airpocket-soundman/IchiPing-UNO-Q/uno_q/audio/reports/2026-09-11-speaker-pass.md

# Bounded speaker playback PASS — 2026-09-11

- Time: 22:54 JST (final listening confirmation).
- Board: Arduino UNO Q, ADB serial `2261748543`, Debian kernel
  `6.16.7-g0dd6551ae96b`.
- Audio hardware connected: MAX98357A, speaker, INMP441, common ground;
  MAX98357A SD connected to SOC_GPIO_28 with an external 10 kOhm pulldown.
- Software: current working-tree `safe-audio-test.sh`,
  `audio-smoke-test.py`, SD_MODE Device Tree route, and Arduino Bridge LED
  Matrix marker. This result precedes a repository commit.
- Stimulus: generated 440 Hz stereo S16_LE PCM at 48 kHz, 0.5 seconds.
- Result at 0.3%FS: user heard a clean sine wave; playback stopped after the
  bounded interval.
- Result at 0.6%FS: user reported the test was fully satisfactory. PCM transfer
  completed, then the route was disabled, SD_MODE returned Low, and markers
  were cleared. No board reset was requested.
- Verdict: **PASS for generated speaker playback and bounded stop control.**
  Microphone capture quality and capture-to-speaker replay remain unvalidated.
