airpocket-soundman/IchiPing-UNO-Q/uno_q/audio/reports/2026-09-10-owon-api.md

# OWON API bring-up — 2026-09-10 19:20–19:22 JST

結果: USB/API取得・停止は成功。**電圧換算はレンジ依存の不整合があり未検証。**
UNO Qの再生、録音、リセットは行っていない。マイク・アンプは取り外したまま。

- 実機: VDS1022I25070056、hardware V5.0.1、FPGA v5。
- API: florentbr/OWON-VDS1022、commit a21cee14fc0807ce804657a26772784c4e47b5ef、package 1.1.5。
- 専用venv: `C:/Users/yamas/AppData/Local/Programs/OWON-VDS1022-API/venv`。
- 公式GUIを閉じ、既存のlibusb-win32ドライバーを使用。ドライバー置換なし。
- Windows libusb0のLinux専用is_kernel_driver_active問い合わせがNotImplementedErrorに
  なるため、ラッパー内でWindows/libusb0の場合のみ非該当として扱う。
- ラッパーはFPGAロード、flash書込み、校正保存を禁止。
  既存FPGAイメージが未ロードなら停止する。校正値は読取りのみ。
- calibration SHA256: f5987fd7ee31303933797a418b03cc03f9bfd389daca60914cfc636550e4e3e3。

## 補償出力測定

CH1のみ補償用5V/1kHzへ接続確認済み。CH2の補償接続は未確認で評価しない。
両CH ×10/DC、1.25MS/s、5000点/CH、CH1 rising 2.5V単発。

| run | API全画面レンジ | 波形エッジからの周波数 | p90−p10振幅 | stop応答 |
|---|---:|---:|---:|---|
| 03 | 20 V | 1000 Hz | 10.08 Vpp | true |
| 04 | 50 V | 1000 Hz | 4.80 Vpp | true |
| 05 | 20 V | 1000 Hz | 10.08 Vpp | true |

`local-runs/owon-api-compensation-03`～`05` にADC生値npz、電圧CSV、
機器識別・設定・統計JSON・実行ログを保存（git対象外）。01/02は接続API互換性エラー。
API内蔵周波数カウンター値は0/832Hz等も返したため、短い取得では信用せず
CSV内の立ち上がり周期から計算した値を採用した。

GUIは50V全画面レンジで約5Vppだった。APIの50Vレンジは概ね整合するが、
20Vレンジの2倍表示が再現する。原因は未確定で、V5固有の設定・校正テーブル・
ゲイン制御を調査する。単純に全データを1/2倍して隠さない。
絶対電圧のオフセットも未校正。これらが解決するまで1.8V I²Sの電気的合否には使わない。

## 実行方法

`owon-capture.py` は既定では何も接続しない。補償信号接続済み、GUI終了後にのみ:

```powershell
& C:/Users/yamas/AppData/Local/Programs/OWON-VDS1022-API/venv/Scripts/python.exe uno_q/audio/owon-capture.py uno_q/audio/local-runs/NEW-RUN --range-v 50 --execute
```

出力ディレクトリの上書き禁止、親プロセスの20秒タイムアウトあり。
タイムアウト時は子を終了するが、停止応答は未確認として記録する。
本ラッパーは補償信号向け。UNO Qの0.5秒試験との同期取得はまだ未実装。
