airpocket-soundman/IchiPing-UNO-Q/uno_q/audio/reports/2026-09-10-owon-i2s.md

# 無負荷I²S API測定 — 2026-09-10 20:10–20:12 JST

最新結果: **GPIO98の約3.072 MHzとGPIO99の約48 kHz WSを取得。64クロック/WS周期を確認。**
以前のWS未検出は短いBCLK開始直後の観測に限られる。電圧精度・データ出力・音響品質は未判定。

## 対象・条件

- UNO Q USB serial 2261748543、VID/PID 2341:0078（各試験スクリプトで確認）。
- kernel 6.16.7-g0dd6551ae96b、q6asm-dai SHA256
  c4292c7c9504c7aa01a94cd0007b86213def67a1d4a8123dd23be3ff92653526。
- OWON VDS1022I25070056、hardware V5.0.1、FPGA5、非公式API1.1.5。
- CH1=GPIO98、CH2=GPIO99、共通GND、両プローブ×10/DC。
  ユーザーの「OK」を直前の配線確認への回答として扱った。
- アンプ・マイクは取り外し済み。スピーカー音響テストではない。
- 全画面20Vレンジ、CH1立上がり1.6V指定（API尺度）。
  補償測定でレンジ依存の電圧不整合があるため絶対電圧は合否判定に使わない。
- 48 kHz / stereo / S32_LEの全ゼロPCM、既存instrument-playbackを使用。
  ルート有効化前から500msの独立systemd強制再起動タイマー。期限延長なし。

## 取得

APIの設定キューをwait()で送信後、armed.jsonを保存。
両試験ともalready_triggered=0を確認してからsudo認証を通し、UNO Q試験を開始。
オシロの待機上限60秒は取得待ちの上限であり、UNO Qの500ms期限とは独立。
ADC、CSV、設定・解析JSONをlocal-runs/owon-api-i2s-01と02に保存（git対象外）。

| run | UNO試験開始 JST | サンプルレート | 全幅 | CH1平均周波数 | CH2 | scope stop応答 |
|---|---|---:|---:|---:|---|---|
| 01 | 20:10:56 | 100 MS/s | 50 µs | 3.071400 MHz | WS未確認 | true |
| 02 | 20:12:27 | 25 MS/s | 200 µs | 3.072458 MHz | WS未確認 | true |

CH1は記録中央付近から立ち上がり、後半がクロック列。
したがって実際に観測した駆動区間は約25µs/100µsと短く、定常動作全体ではない。
CH2のp90−p10はAPI尺度で0.16V、48kHzの矩形波は識別できなかった。
この時点ではプローブ・CH2・接触・測定位置・WS開始遅延を除外できない。

run01の元JSONは単一周期サンプル数の中央値から3.030303MHzを出している。
これは周期が32/33点に量子化されるため。全77周期/2507点から3.071400MHzと算出。
以後のコードは全立上がり区間平均に修正。元データは書き換えない。

## 復旧・停止確認

開始前はALSAカードが消失していた。USB識別とaplay/arecord不在確認後、
idle ADSP remoteproc1をstop/startしてカードを回復した。
run01後はboot ID b423aafa-bcf8-4733-8e41-e10dd0e1ba5eに変わり、
前bootのwatchdogログに11:10:57 UTCのRebootingを確認。
これは再起動実施の確認で、厳密な500ms以内のピン停止を実測したものではない。
run02後はSSH再接続が一時タイムアウトしたが、その後復帰。
boot ID 44647f13-f9a2-4459-82b3-b79c9abd2f9cと、前bootの
11:12:28 UTCのwatchdog Rebootingログを確認した。

## 次の切り分け

無負荷を維持し、CH1/CH2ともGPIO98へ接続して測定系を比較する。
同じクロックが両CHに出れば、99番へ戻しWSの開始遅延も含めて測る。
測定系を確認するまでWS出力故障やソフト原因とは断定しない。

## 両CHをGPIO98へ接続した比較 — 20:20:55 JST

ユーザーが両方98番への接続を明示確認。アンプ・マイク未接続、GND・×10を維持。
ボード・kernel・q6asm・OWON/API・校正hashは上記と同一。
100MS/s、5000点、50µs、20V全幅、CH1立上がり1.6V（API尺度）。
同じ500msリセット期限付きゼロPCMを1回実行。

- `local-runs/owon-api-both98-01`: 試験前のalready_triggered=3のためUNO実行を中止。
  取得は60秒タイムアウト、当該runのscope停止応答は未確認。波形評価には使わない。
- `owon-capture.py`に初期化設定送信→明示STOP→測定設定→RUNを追加。
  stop()は初期化キューを破棄するため、キューを送信するsend(SET_RUNSTOP,1)を使用。
- `local-runs/owon-api-both98-02`: already_triggered=0を確認後にUNO試験を開始。
  CH1/CH2とも平均3.071400MHz、p90−p10=2.00V（API尺度、絶対値未検証）。
  生ADC相関0.998035、完全一致サンプル0.26%。別チャネルの実測値としてほぼ同じ波形。
  API取得後stop_acknowledged=true。SVGを保存し公式アプリを再起動。
- 比較の合否: 両CHでBCLK検出は成功。電圧精度・音質の合格ではない。
  CH2の恒常的な無応答は否定できるが、前回99番の接触不良や開始遅延は未除外。
- UNO再起動直後のSSHは一時タイムアウトしたが復帰。
  boot ID 11b2a1f9-5068-43cb-b76c-d6f4cb9a4d56、前bootの11:20:56 UTC
  watchdog Rebootingログを確認。厳密なピン停止時間を実測したものではない。

次はCH1を98番に維持し、CH2を99番へ戻して接触確認後、WSを再測定する。

## CH2を99へ戻して再測定 — 20:26–20:27 JST

ユーザーがCH2=99を明示確認。CH1=98、アンプ・マイク未接続、×10/DC/GND共通。
機器識別・kernel・q6asm・校正hashは上記と同一。全ゼロPCM、500ms期限を維持。
再度ALSAが消えていたため、USB識別と再生・録音不在確認後にidle ADSP stop/startで回復。
公式アプリは終了し、以後再起動せずSVGを提示する。

| local-runs末尾 | UNO開始JST | 設定 | 結果 |
|---|---|---|---|
| owon-api-ws-return-01 | 実行せず | 25MS/s | 試験前trigger=3、破棄。取得timeout、当該停止応答未確認 |
| owon-api-ws-return-02 | 20:26:07 | 25MS/s、200µs | CH1 3.072458MHz、CH2 WS未確認、p90−p10=0.16V* |
| owon-api-ws-return-03 | 20:27:42 | 1MS/s、5ms | CH2 WS未確認、p90−p10=0.08V*。CH1は帯域不足で評価禁止 |

*V値は未検証API尺度であり、物理的な電圧精度を保証しない。
02/03は試験前trigger=0を確認後に実行し、取得後scope stop=true。
誤トリガー時は即例外で終了・停止する処理を追加（01実行後から適用）。
03の5ms記録は前後半を含むため、クロック開始後を見た時間は約2.5ms。
これより後のWS開始を除外したわけではない。BCLKのaliasはJSON/SVGに明記。
02の再起動boot ID c1e54395-3b6b-495c-a795-3d4a3e2e3d1d、前bootの11:26:08 UTC
watchdog開始ログを確認。03もboot ID b6d5afec-164d-44d9-b9ec-1d1a7e71488fへ変化、
前bootの11:27:43 UTC watchdog開始ログを確認。厳密なピン停止時間の実測ではない。

判断: CH2の恒常的な無応答では説明できず、99番のピン設定・実測接触位置・
WS開始遅延を次に確認する。アンプは未接続なので、今回のWS未検出をアンプ負荷のせいにはできない。
ただし全駆動期間のWS不在、ソフト障害、ノイズ原因の確定には至っていない。

## WS自身のトリガーによる取得成功 — 20:40:47 JST

同じUNO Q 2261748543 / 2341:0078、kernel 6.16.7-g0dd6551ae96b、q6asm hashは上記と同一。
OWON VDS1022I25070056 / V5.0.1 / FPGA5 / API1.1.5、校正hash不変。
アンプ・マイク未接続、CH1=98、CH2=99、×10/DC/GND共通。
全ゼロPCM、500ms独立リセット期限を維持し、1回試験。

実機pinmux-pinsでgpio6=i2s1_clk、gpio7=i2s1_ws、gpio8/9=i2s1_data、owner=soundを確認。
[Arduino公式カーネル定義](https://github.com/arduino/linux-qcom/blob/qcom-v6.16.7-unoq/drivers/pinctrl/qcom/pinctrl-sm6115-lpass-lpi.c)
とも整合。根拠なくDTやカーネル設定を変更していない。

取得をCH2 rising 1.6V（API尺度）、25MS/s・5000点・200µsへ変更。
`local-runs/owon-ws-trigger-01`に保存。armed時trigger=0、取得後stop=true。
CH1平均3.071758MHz、CH2平均47.984645kHz、連続4つのWS周期内BCLKエッジ数は全て64。
WSが始まる前の約100µsにもBCLKが存在し、WS開始時点を捕捉した。
過去のBCLK-trigger記録では開始後2.5msまでWSなし、今回WS-triggerではWSを取得。
同一試験で開始間隔全体は測っていないため、遅延時間を厳密には確定しない。
これまでの未検出をWS出力故障とは解釈しない。周波数・比率確認は成功、音響品質合格ではない。

APIにtrigger-ch選択、45秒の停止タイマー（親60秒上限）を追加。これはオシロ待機であり、
UNO Qの500ms期限を延ばさない。データ測定に備えてCH2=101の記録指定も追加。
次の物理操作はCH2のみ99→101。未変更のためデータ線の実測はまだ行っていない。
試験後boot ID bc0a8655-d0d5-4a1e-b849-3b66489f500fと11:40:48 UTCのwatchdog
Rebootingログを確認。再起動は確認済みだが、厳密なピン停止時間の実測ではない。
