airpocket-soundman/IchiPing-UNO-Q/docs/HANDOFF_2026-09-12.md

# IchiPing UNO Q 引継ぎ資料 — 2026-09-12 JST

## 1. 最初に読むこと

このリポジトリは元IchiPingをArduino UNO Qへ移植する独立プロジェクトである。
元の `airpocket-soundman/IchiPing` は参照専用で、変更・逆同期しない。

- 開発方針・配線・GPIOの正本: [`docs/uno_q_port.html`](uno_q_port.html)
- UNO Qアプリの正本: [`uno_q/app/`](../uno_q/app/)
- 今回の実装監査: [`uno_q/reports/2026-09-12-implementation-gap-audit.md`](../uno_q/reports/2026-09-12-implementation-gap-audit.md)
- 音響bring-up: [`uno_q/audio/README.md`](../uno_q/audio/README.md)
- GPIO28 / MAX98357A SD制御: [`uno_q/audio/SDMODE_GPIO28.md`](../uno_q/audio/SDMODE_GPIO28.md)
- オリジナルUI比較: [`uno_q/reports/2026-09-12-original-ui-port.md`](../uno_q/reports/2026-09-12-original-ui-port.md)

## 2. 現在の結論

ILI9341、D3–D8入力、PCA9685、5台のSG90、Router Bridge、MI2S0再生・録音、
ONNXモデル単体のbring-upは完了している。2026-09-12に、EXECから録音、前処理、
baseline差分、ONNX推論、TFT表示までのソフト経路も統合した。

ただし、ホワイトノイズの実機音量が学習データ相当に校正されていないため、root所有の
音響workerは意図的に未インストールである。現在のEXECは発音・録音しない。この状態を
回避して推論成功を装うloopback/dummy経路はない。

サーボ制御も再起動後は必ず未armed・自動追従OFFである。5台すべての同期が成功するまで
TFTの `act` は `-----` を表示する。同期後の `act` も位置センサー値ではなく、最後に成功
した端点指令を表す。

雨検知は対象外である。D9は予約・未使用のままにする。

## 3. 実機と稼働状態

| 項目 | 現在値 |
|---|---|
| ボード | Arduino UNO Q、USB serial `2261748543` |
| Wi-Fi | host `unoQ4G`、直近IP `192.168.50.160` |
| Linuxログイン | 試験ユーザー `airpocket`。パスワードはGitへ記録しない |
| アプリ配置 | `/home/arduino/ArduinoApps/ichiping-uno-q` |
| アプリ名 | `IchiPing UNO Q` |
| アプリ状態 | running、直近確認時container restart count 0 |
| MCUビルド | program 31,432 bytes、global RAM 6,596 bytes |
| 起動status | `0x03`: ILI9341初期化送信済み、PCA9685検出 |
| 起動入力 | switch request `0b11111`、servo state `unknown` |
| 音響worker | 未有効。`worker-ready.json`なしが正常 |
| baseline | 未収録 |

直近配備ソースのSHA-256は以下。再配備前の照合に使用できる。

| ファイル | SHA-256 |
|---|---|
| `sketch/sketch.ino` | `305cea7ddce6133afddecfec10fd5829e592271c26a3bb611b68b060823b8668` |
| `sketch/ili9341_display.cpp` | `1d42182fc9c7b3cbacf2388a7b9cd00c703ebd2af733ffad2502914f36d098a0` |
| `sketch/ili9341_display.h` | `a3d2635a924e820fb8f10cc062e0d667a5f293e44a2780440592004d7f761430` |
| `python/main.py` | `5eed43f6227800a120ae275fa10b8521014586d07cc4f4e2f8b568e9d80e612d` |

## 4. 現行配線

### ILI9341

`D11=MOSI`、`D13=SCK`、`A2=CS`、`A3=RST`、`A4=DC`、`A5=BL`、
`3V3`、`GND`。書込専用なのでD12/MISOは未接続。

### スイッチ・EXEC・サーボ

- D3–D7: bit 0..4 = 窓a、窓b、窓c、扉AB、扉BC
- 状態スイッチ: GND接続Low=CLOSE(0)、解放High=OPEN(1)
- D8: EXEC、Low=押下
- D20/SDA、D21/SCL: PCA9685アドレス0x40
- PCA9685 ch 0..4: a、b、c、AB、BC
- サーボ: 0°/tick 102=OPEN、180°/tick 553=CLOSE
- サーボ電源: 外部5 V、UNO QとGND共通。3.3 V端子から給電しない

### MI2S0

| 信号 | SoC GPIO | 接続 |
|---|---:|---|
| BCLK/SCK | 98 | MAX98357A BCLK、INMP441 SCK |
| WS/LRC | 99 | MAX98357A LRC、INMP441 WS |
| mic SD / DATA0 | 100 | INMP441 SD |
| amp DIN / DATA1 | 101 | MAX98357A DIN |
| amp SD_MODE | 28 | MAX98357A SD、SD–GND外付け10 kΩ必須 |

48 kHz、stereo、S32_LEコンテナ内上位24 bit。INMP441 L/R=GND、VDD=1.8 V。
MAX98357A GAIN=GND、VIN=5 V。信号は標準UNO D番号ではなくJMISC／UNO Breakout
Carrier経由である。配線変更は必ず電源OFFで行う。

## 5. 完了している実装

- 元IchiPing project 10準拠のILI9341横画面、`inf`/`act`、物理順
  `c, BC, b, AB, a`、可観測性の色、3段階判定
- EXEC要求のmailbox化。Bridge provider内の同期再入によるtimeoutを解消
- 6秒録音、中央2秒抽出、48 kHz→16 kHz変換、Welch特徴量、baseline差分
- モデルSHA、入出力名・shape、サンプルレート、状態順のmanifest検証
- 3本の全閉baselineをatomic保存し、モデル変更・破損時に拒否する処理
- 録音時間、無音、クリップ、左右slot漏れの健全性検査
- 収録時状態とrequest IDによる古い推論結果の拒否
- 推論busy中のEXEC抑止とサーボ同期延期
- PCA9685全16ch FULL_OFF、明示arming、ch 0..4制限、障害ラッチ
- MAX98357A SD_MODEのGPIO28制御、正常終了・例外時のroute offとSD Low
- root音響workerとApp Labコンテナのファイルspoolによる権限分離
- オンボードLED Matrix依存の削除。音響マーカーはLinux緑LEDのみ

暫定Neutron-XLは追跡済み代表録音160本で学習し、別の代表32本で32-class
30/32（93.75%）、14-class 32/32（macro-F1 1.0）。少数データによる参考値で、
未知条件に対する最終精度ではない。UNO Q上のwarm推論p95は1.659 ms、計測RSSは
61.8 MiBで予算内。

## 6. 次に行う作業

順番を変えないこと。

1. 作業ツリーを保全し、ボードserial、配線、5 V、共通GND、SD–GND 10 kΩを確認する。
2. ALSAカード `Arduino-Imola-IchiPing-MI2S0` とGPIO28のLowを無音状態で確認する。
3. 安全スクリプトで低いRMSから5秒ホワイトノイズを1回だけ再生・6秒録音する。
4. 録音を `analyze-white-noise-calibration.py` で解析し、次の音量へ進む前に結果を確認する。
5. 最大2倍刻みで、学習データと同程度の録音RMSになる再生値を決める。
6. 決定値を指定して `install-runtime-audio-service.sh` を実行し、workerを有効化する。
7. サーボ電源・GND・機械端を再確認し、明示的にarmして全閉同期する。
8. `act=00000` を確認してEXECを1回押し、独立した全閉baseline 3本を収録する。
9. baselineメタデータ、録音健全性、停止後SD Lowを確認する。
10. 32状態を実機評価し、日時、commit、serial、ソフト版、配線、正解、推論、RMSを記録する。
11. 追加データを含めて再学習し、未知収録日・雑音・設置差のmacro-F1でモデルを比較する。

confidence/OOD閾値は追加live datasetで決める。現時点の小規模評価から任意の閾値を
設定しない。大型モデルやensembleは、外部評価が改善した場合だけ採用する。

## 7. 音響試験の停止条件

- 一回の校正発音は5秒、録音は6秒。次の発音前に必ず録音を解析する
- 予期しない連続音、濁った大音量、停止失敗、ALSAエラー、SD Low不成立では即中止
- エラー時も `aplay`/`arecord`停止、route off/verify、SD Low、LED消灯を確認する
- 通常試験でシステムリセットを停止手段にしない
- MAX98357A出力はBTL。OUT+／OUT−へ通常プローブのGNDを接続しない
- アンプやマイクを未給電のまま信号線だけ接続しない

## 8. テストと配備

Windows側の回帰テスト:

```powershell
& 'D:\GitHub\IchiPing-UNO-Q\pc\.venv\Scripts\python.exe' -m unittest discover -s uno_q/app/python -p 'test_*.py' -v
& 'D:\GitHub\IchiPing-UNO-Q\pc\.venv\Scripts\python.exe' -m unittest discover -s uno_q/audio -p 'test_*.py' -v
```

直近結果はアプリ24件、音響・計測33件の合計57件すべてPASS。

SSHユーザー `airpocket` からApp CLIを実行する場合、Arduinoコアは `arduino`
ユーザー側にある。次の形式を使う。`airpocket` の環境で直接起動すると
`Platform 'Arduino:zephyr' Not Found` になる。

```sh
sudo -u arduino env TMPDIR=/tmp arduino-app-cli app start /home/arduino/ArduinoApps/ichiping-uno-q
sudo -u arduino env TMPDIR=/tmp arduino-app-cli app logs /home/arduino/ArduinoApps/ichiping-uno-q --all
sudo -u arduino env TMPDIR=/tmp arduino-app-cli app list
```

MCU書き込み前は必ずUSB VID/PIDまたはADB serialで対象個体を確認する。アプリ再起動は
MCU側でPCA9685全chをFULL_OFFにするが、サーボ位置同期や音響worker有効化は行わない。

## 9. Gitの注意

作成時点のbranchは `main`、HEADは `0f91aa7`。その上に今回の移植・モデル・試験・
文書の未コミット変更が多数ある。これらは進行中成果であり、`git reset --hard`、
`git checkout --`、cleanによる削除をしない。元IchiPingリポジトリにも変更を加えない。

`pc/runs/uno_q_retrain_representative_20260911/`、`uno_q/app/models/`、新しいruntime・
テスト・レポートも未追跡項目を含む。コミット前にモデル、manifest、代表評価記録を
一組として確認する。`.cache`、仮想環境、runtime spool、生RAW/CSV/SR、認証情報は
コミットしない。

## 10. 既知の未解決事項

- 起動によってALSAカードが現れないことがある。無音・SD Lowでログを保存し、既存の
  ADSP復旧記録を参照する。発音中の緊急停止としてADSP再起動を使わない
- SLogic16U3はこのPCのUSBハブではUSB3通常モードを認識できず、別PC切り分け待ち
- 32状態の実機end-to-end精度は未測定
- サーボ位置センサーはないため、`act`は機械位置そのものを証明しない
- 音響workerのインストール／有効化とbaseline生成は未実施
- 追加学習データによる未知条件評価とconfidence/OOD設計は未実施
