airpocket-soundman/IchiPing-UNO-Q/board/DRILL_CHECK.md

# スルーホール部品の穴検査 — 2026-09-08

EasyEDAで開いているローカル版を対象に、部品パッドと新規出力した製造用ドリルデータを照合した。基板設計の変更は行っていない。

| 基板 | 部品数 | 部品パッド数 | めっき穴との照合 | DRC |
|---|---:|---:|---|---|
| UNO shield | 19 | 70 | 全70箇所一致 | 0件 |
| Audio shield | 12 | 107 | 全107箇所一致 | 0件 |

部品用穴径は0.8、0.95、1.0 mm。各部品パッドは多層パッドかつめっき有効で、`Drill_PTH_Through.DRL`に対応する穴が存在した。J14/J15はそれぞれ40箇所の1.0 mm穴。UNO shieldの取付穴4箇所は、別の非めっきドリルデータに3.2 mmとして出力されている。

位置照合の許容差は0.002 mm、穴径は0.0001 mm。使用中クライアントの部品パッドAPIはXYをmil、holeをソース単位（0.01 inch）で返すため、製造データのmm値との比較で単位を検証した。API値だけを一律milとして解釈すると穴径を10分の1に誤認する。

穴の欠落は見つからなかった。画面上で穴が見えない原因はこの検査だけでは特定していない。また、これは採用部品の実物リード寸法との全数適合確認や、基板全体の製造承認ではない。

検査スクリプト: `scripts/audit_pad_drills.py`。実行時のスナップショット、Gerber ZIP、照合結果は `.cache/pcb-repair-20260908/` の `*-drill-*` に保存。
