airpocket-soundman/IchiPing-UNO-Q/hardware/easyeda/IchiPing-UNO-Q-Shields/PIN_MAPPING.html

← IchiPing UNO Qトップ ／ 基板仕様書

UNOレイアウト・シールドとUNO Breakout Carrier Audio shieldの全使用ピン

# IchiPing UNO Q 全機能ピン接続対応表

版: Rev B / 2026-09-07。XHのPin番号は、基板上面から見てシルクのPin 1マーク側から数える。

通電前の注意: UNOレイアウト・シールド装着時にUNO Qの電源断が発生したため、 現物の+5V–GND、3V3–GND、ヘッダ向き、はんだブリッジを無通電で確認するまで 再装着しない。外部安定化5 VはUNO Qの+5V端子へ接続し、VINへは接続しない。

## 1. 全機能の概要

機能 | UNO Q／Carrier側 | シールド側コネクタ | 接続先
窓a～c、扉AB/BC | D3～D7 | J_WIN_A～J_DOOR_BC | トグルスイッチ
実行ボタン | D8 | J_EXEC | モーメンタリスイッチ
雨入力 | D9 | J_RAIN | 3.3 V雨センサ D0
サーボ制御 | D20/SDA、D21/SCL | J_SERVO_CTRL | PCA9685ロジック側
サーボ電源 | 外部+5 V | J_PWR_IN、J_SERVO_5V_OUT | PCA9685 V+
表示 | D11～D13、A2～A5 | J_TFT_SIG、J_TFT_PWR | ILI9341 SPI TFT
音声入力 | J15-32/34/36、J14-19 | J_MIC | INMP441等のI2Sマイク
音声出力 | J15-32/34/38、J14-7 | J_AMP_SIG、J_AMP_PWR | MAX98357A

## 2. スイッチ

全入力はUNO Qの内部プルアップを使用するアクティブLow。スイッチON／押下で信号をGNDへ落とす。

コネクタ | Pin 1 | Pin 2 | 状態bit／用途
J_WIN_A | D3 / WIN_A | GND | bit 0、窓a
J_WIN_B | D4 / WIN_B | GND | bit 1、窓b
J_WIN_C | D5 / WIN_C | GND | bit 2、窓c
J_DOOR_AB | D6 / DOOR_AB | GND | bit 3、扉AB
J_DOOR_BC | D7 / DOOR_BC | GND | bit 4、扉BC
J_EXEC | D8 / EXEC | GND | 推論実行

## 3. 雨センサ J_RAIN（3極）

XH Pin | 表示 | UNO Q接続 | 雨センサ端子
1 | VCC | 3V3 | VCC
2 | GND | GND | GND
3 | D0 | D9 | D0

D0が3.3 Vを超えない3.3 V動作モジュールを使用する。

## 4. PCA9685サーボコントローラ

### J_SERVO_CTRL（4極、ロジック）

XH Pin | 表示 | UNO Q接続 | PCA9685端子
1 | GND | GND | GND
2 | SCL | D21 / SCL | SCL
3 | SDA | D20 / SDA | SDA
4 | VIN | 3V3 | VCC（ロジック電源）

このコネクタのVIN表示はPCA9685モジュールのロジック電源端子を意味し、3.3 Vである。 サーボ用V+へは接続しない。

### J_PWR_IN／J_SERVO_5V_OUT（2極、サーボ電源）

コネクタ | Pin 1 | Pin 2 | 接続先
J_PWR_IN | +5V_IN | GND | 外部安定化5 V入力 → UNO Qの+5V端子
J_SERVO_5V_OUT | +5V_SERVO | GND | PCA9685のV+。J_PWR_INから直接分岐

PCA9685のGND、UNO QのGND、外部5 V電源GNDを共通化する。サーボPWMのch 0～4は 窓a、窓b、窓c、扉AB、扉BCの順。

## 5. ILI9341 TFT

### J_TFT_SIG（5極）

XH Pin | 表示 | UNO Q端子 | ディスプレイ端子
1 | MISO | D12 | MISO / SDO
2 | LED | A5 | LED / BL
3 | SCK | D13 | SCK / CLK
4 | MOSI | D11 | MOSI / SDI / SDA
5 | DC | A4 | DC / D-C / RS

### J_TFT_PWR（4極）

XH Pin | 表示 | UNO Q端子 | ディスプレイ端子
1 | RST | A3 | RST / RESET
2 | CS | A2 | CS
3 | GND | GND | GND
4 | VCC | 3V3 | VCC / 3V3

タッチパネル用のT_CS/T_CLK/T_DIN等には接続しない。現行ドライバは書き込み専用だが、 ハーネス互換性のためD12をMISO/SDOへ配線する。

## 6. Audio shield — UNO Breakout Carrier使用端子

1.8 V専用: J15-32/34/36/38はQRB2210の1.8 Vロジック。 3.3 Vまたは5 V信号を入力しない。2x20ソケットは表裏で左右が反転して見えるため、位置ではなく Pin 1表示とパッド番号で照合する。

Carrier端子 | 公式信号名 | MI2S0機能 | 方向 | 接続先
J15-32 | SOC_GPIO_98 | MI2S0_CLK | UNO Q出力 | AMP BCLK、MIC SCK
J15-34 | SOC_GPIO_99 | MI2S0_WS | UNO Q出力 | AMP LRC、MIC WS
J15-36 | SOC_GPIO_100 | MI2S0_DATA0 | UNO Q入力 | MIC SD/DOUT
J15-38 | SOC_GPIO_101 | MI2S0_DATA1 | UNO Q出力 | AMP DIN
J14-7 | +5V USB OUT | — | 電源出力 | AMP VIN、SD
J14-19 | +1V8 OUT | — | 電源出力 | MIC VCC
J15-40 | GND | — | — | 全GND、AMP GAIN、MIC L/R

### MAX98357A: J_AMP_SIG（4極）

XH Pin | 表示 | Carrier接続 | MAX98357A端子 | 設定
1 | LRC | J15-34 | LRC | MI2S0_WS
2 | BCLK | J15-32 | BCLK | MI2S0_CLK
3 | DIN | J15-38 | DIN | MI2S0_DATA1
4 | GAIN | J15-40 / GND | GAIN | GND直結、12 dB

### MAX98357A: J_AMP_PWR（3極）

XH Pin | 表示 | Carrier接続 | MAX98357A端子 | 設定
1 | SD | J14-7 / +5V | SD / MODE | VIN直結、常時有効・左ch
2 | GND | J15-40 / GND | GND | 共通GND
3 | VIN | J14-7 / +5V | VIN | アンプ電源

### I2Sマイク: J_MIC（6極）

XH Pin | 表示 | Carrier接続 | マイク端子 | 設定
1 | GND | J15-40 / GND | GND | 共通GND
2 | VCC | J14-19 / +1V8 | VDD / VCC | 1.8 V
3 | SD | J15-36 | SD / DOUT | MI2S0_DATA0
4 | SCK | J15-32 | SCK / BCLK | MI2S0_CLK
5 | WS | J15-34 | WS / LRCLK | MI2S0_WS
6 | L/R | J15-40 / GND | L/R / SEL | GND直結、左ch

Audio shieldの最小構成: J14、J15、J_AMP_SIG、J_AMP_PWR、J_MICのみ。 抵抗、ジャンパ、追加コンデンサは置かず、必要なデカップリングを搭載済みのMAX98357A／ I2Sマイク・ブレークアウトモジュールを使用する。

## 7. EasyEDA保存データ監査

2026-09-07にboard/Ichiping uno q.eprj2の回路図・PCBネット・部品属性を読み取り検査した結果。 異なるネットの配線中心線が同一銅箔面で交差する箇所は、UNOシールド、Audio shieldとも0件だった。 ただし、これはEasyEDAの正式なDRC、フットプリント実寸、現物の導通検査を代替しない。

重要度 | 対象 | 監査結果 | 必要な対応
P0 | UNOシールド現物 | 装着時の電源断は設計データ上の異ネット配線交差では説明できない。+5VはJ1-5、GNDはJ1-6/7、VINはJ1-8で、ネット名上は分離している。 | 再装着せず、無通電で+5V–GND、3V3–GND、VIN–GNDを測定する。XHハーネスを全て外した状態から確認し、はんだブリッジ、ヘッダの裏表、現物のPin 1を調べる。
P0 | 全外部コネクタ | EasyEDA部品属性は2044-1X...の汎用ピンヘッダ、またはPinSocket_1x03であり、XH垂直コネクタの部品・フットプリントになっていない。 | 全コネクタを指定のXH垂直・2.54 mmフットプリントへ交換し、Pin 1位置と実部品の嵌合方向を確定する。
P1 | Audio shield | MAX98357Aのデータシート上のデジタル入力High最小値は1.3 Vであり、QRB2210の1.8 V MI2S0とは電圧上互換。ただしJ15-32/34/36/38のPinMux、DATA0/1方向、Device Tree、ALSA経路は実機未確定。 | ブレークアウトモジュール固有回路も確認し、Device TreeとALSA経路を確定するまで接続・製造しない。MI2S0を利用できない場合はUSB Audioへ切り替える。
P1 | Audio shield部品 | 現在のPCBは12部品で、C1～C3、R_GAIN、R_LR、R_SD、JP_MUTEが残っている。最小構成5部品という現行仕様と不一致。 | 受動部品を削除し、GAIN→GND、SD→+5V、MIC L/R→GNDへ直結して回路図からPCBを更新する。
P1 | UNOシールド電解コンデンサ | C_PWR_BULKは「470u」、C_SERVO_BULKは「1000u」と表示されるが、部品属性は両方ともCL21B104KCFNNNE（100 nF系MLCC）で、極性付き電解コンデンサのBOMになっていない。 | 容量、耐圧、極性、DIPリード間隔、外径が一致する電解コンデンサのシンボル・フットプリント・BOMへ修正する。
P1 | サーボ5 V配線 | J_PWR_INからJ_SERVO_5V_OUTの一部が約0.41 mm、UNO +5V／バルク部への配線が約0.64 mmで、+5V層間接続に小径ビアも使われている。複数SG90の突入電流には細い。 | サーボ電流経路は可能なら同一面で短くし、銅箔幅とビア本数を想定ピーク電流に合わせて増やす。UNOへ向かう分岐とサーボV+分岐をスター配線にする。
P1 | USBと外部5 V | 外部5 V入力はUNO Qの+5Vへ直結され、逆流防止・電源選択・ヒューズがない。 | USB給電と外部5 Vを同時接続する条件を禁止するか、ジャンパ、ショットキー／理想ダイオード、ポリヒューズ等で競合と逆流を防ぐ。
P2 | TFT LED | A5からTFTのLED/BLへ直接接続している。使用するILI9341モジュールのLED端子がロジック入力ではなく生のバックライト電源ならGPIO過電流になる。 | 対象モジュールの回路を確認し、生LED端子なら抵抗とトランジスタ／MOSFETで駆動する。
OK | UNO外形・ヘッダ | PCB外形は約68.58 × 53.34 mm。J1～J4の並びとネット割当はUNO R3配置に一致し、+5VをVINへ接続する配線はない。 | フットプリントのPin 1表示と、実際に下面へ差し込む長ピンの向きだけを現物で最終照合する。
OK | Audio配置 | J_AMP_SIG、J_AMP_PWR、J_MICはJ15より右側に配置されている。 | 部品削除・XH化後も右側配置を維持する。

DRCについて: EasyEDA画面に表示されていたAll (0)だけでは、保存後に正式なDRCが再実行されたことや、論理的に間違ったネット名を検出したことは保証できない。 上記P0/P1を修正後、回路図ERC、回路図からPCB更新、未配線、PCB DRCを順に再実行して全項目0件を確認する。

## 8. 製造前チェック

1. USBと外部5 Vを外し、シールド単体で+5V–GNDおよび3V3–GNDが短絡していないことを測る。
2. UNOヘッダ、J14/J15、全XHのPin 1位置を回路図・PCB・現物で照合する。
3. EasyEDAの回路図DRC、PCB DRC、未配線チェックをすべて0件にする。
4. 最初はサーボを外し、UNO Q単体 → シールドのみ → PCA9685ロジック → TFT → スイッチの順で接続する。
5. PCA9685の0x40 ACK確認後も、外部5 V、共通GND、機械端を確認するまでPWMを有効にしない。

## 9. 関連資料

- シールド基板仕様書
- TFTピン対応表
- Audio shieldピン対応表
- UNO Q移植方針・GPIO正本
- Arduino UNO Breakout Carrier datasheet (https://docs.arduino.cc/resources/datasheets/ASX00085-datasheet.pdf)
- Arduino UNO Breakout Carrier schematic (https://docs.arduino.cc/resources/schematics/ASX00085-schematics.pdf)
