airpocket-soundman/IchiPing-UNO-Q/uno_q/audio/reports/2026-09-10-owon-din.md

# 無負荷データ線測定 — 2026-09-10 20:46–20:48 JST

結果: **GPIO101の実測ビット列339ビットが送信サインPCMの一部分と完全一致。**
WS同時取得なしの部分列照合であり、I²Sフレーム位相・左右・音響品質は未判定。

## 識別・条件

- UNO Q 2341:0078 / serial 2261748543（各試験で照合）。
- kernel 6.16.7-g0dd6551ae96b、q6asm-dai SHA256
  c4292c7c9504c7aa01a94cd0007b86213def67a1d4a8123dd23be3ff92653526。
- OWON VDS1022I25070056 / hardware V5.0.1 / FPGA5 / 非公式API1.1.5。
- calibration SHA256 f5987fd7ee31303933797a418b03cc03f9bfd389daca60914cfc636550e4e3e3。
- ユーザーが変更確認: CH1=GPIO98/BCLK、CH2=GPIO101/DIN、×10/DC、GND共通。
- マイク・アンプ未接続。20V全画面API尺度。絶対電圧は未検証。
- 同じ安全スクリプトinstrument-playback、ルート前500ms独立強制リセット期限。
- 開始前ALSA未認識をUSB識別・再生録音不在確認後のidle ADSP stop/startで復旧。

## 取得結果

| run | UNO開始JST | 取得条件 | 観測 |
|---|---|---|---|
| owon-din-zero-01 | 20:46:26 | CH1 trigger、100MS/s、50µs | DINの大きな遷移なし。p90−p10=0.08V* |
| owon-din-sine-01 | 20:48:25 | CH2 trigger、25MS/s、200µs | DINの疎なHighパルスを捕捉、BCLK約3.072374MHz |

両runともarmed時trigger=0、取得後scope stop=true。データ・SVGはlocal-runs配下。
ゼロ測定は開始直後だけで、全転送期間のゼロを証明しない。
サイン測定ではHighが疎なためp90−p10が小さくてもデータは存在する。
周波数用のパーセンタイル判定を「データなし」判定に転用しない。

送信は48kHz/stereo/S32_LE、24MSB、500msファイル、100ms先頭ゼロ、
100msの440Hzサイン・5msフェード、300ms末尾ゼロ。振幅0.01%FS以下。
sine.raw SHA256 9d0d3d1464f6b9795d965e6f5292a72908909ada0d3da2197be748ef3c169fac。
実行前にボード上の検証処理が長さ・振幅・24MSB配置を確認。

## ビット比較

compare-din-capture.pyでCH1立上がり直後のCH2を二値化。
614ビット取得、先頭の長いゼロを除き最初のHigh前32ビットから339ビットを照合。
Highは18ビット。送信PCMのMSB-first 32-bit stereoビット列に完全一致する候補は1か所:
bit offset 307319 = PCM frame 4801、frame内bit55。
API閾値0.8/1.0/1.4/1.8Vで全て同じ339ビット・同じ候補位置。
閾値の狭い調整による偶然の一致ではないが、短い部分列の候補照合に留まる。

WSなしでは、正しいチャンネル境界・I²S 1-bit delay・全期間の正しさを証明できない。
この結果からスピーカー出力やマイク録音が正常とは判断しない。
次はWSとDINの相対位置、最終的にはBCLK/WS/DINの3信号同時取得で確認する。

## 停止確認

ゼロ試験後boot ID c5a68715-ef49-4944-bba7-2b76f55a5372、11:46:27 UTC
watchdog Rebootingを確認。サイン試験後はSSH切断後に復帰し、
boot ID 0d6f86e2-c9c4-43ee-b467-836c83586ba9、11:48:26 UTC watchdog開始を確認。
オシロ停止応答は両方true。厳密な500ms以内のピン停止時間は実測していない。

## WS/DIN同時取得 — 20:52:25 JST

ユーザーの接続変更確認後、CH1=99/WS、CH2=101/DIN、他の機器・未接続条件・
ソフト版・PCM・500ms期限は上記と同一で1回測定。
`local-runs/owon-ws-din-01`、25MS/s・5000点・200µs、CH2 rising 1.6V指定。
armed時trigger=0、scope stop=true。WS平均47.996160kHz。

compare-ws-din.pyでWS半周期を32ビットに分割して推定サンプル位置を計算。
標準I²Sの1-bit delayに対応するWS変化後1.5bitからの読み取りで18スロット（9フレーム）が
送信PCMと一致。左右はともに0,0,0,0,256,512,768,1280,1792（S32コンテナ整数）。
0.5bit開始なら非ゼロ値が半分、2.5bit開始なら2倍になり、いずれも18スロット列の一致なし。
これは先頭付近の小さい正値のみの検証であり、負値・フルサイン周期・転送終端は未検証。
左右同一PCMのため、チャンネルの取り違え自体は検出できない。

重要: BCLKは今回同時測定していない。過去の64クロック/WS周期に基づく推定であり、
実際のBCLKエッジのsetup/holdや欠落まで保証しない。無負荷の観測区間では標準I²Sと整合。
アンプ接続時・音響品質・マイク品質は依然未判定。

boot ID f1c5aad2-2f3a-490f-8579-5d221db0582e、11:52:26 UTC watchdog開始、
11:52:27 UTC Rebootingを確認。厳密なピン停止時刻は実測していない。
