airpocket-soundman/IchiPing-UNO-Q/output/pdf/audio-schematic-after.pdf

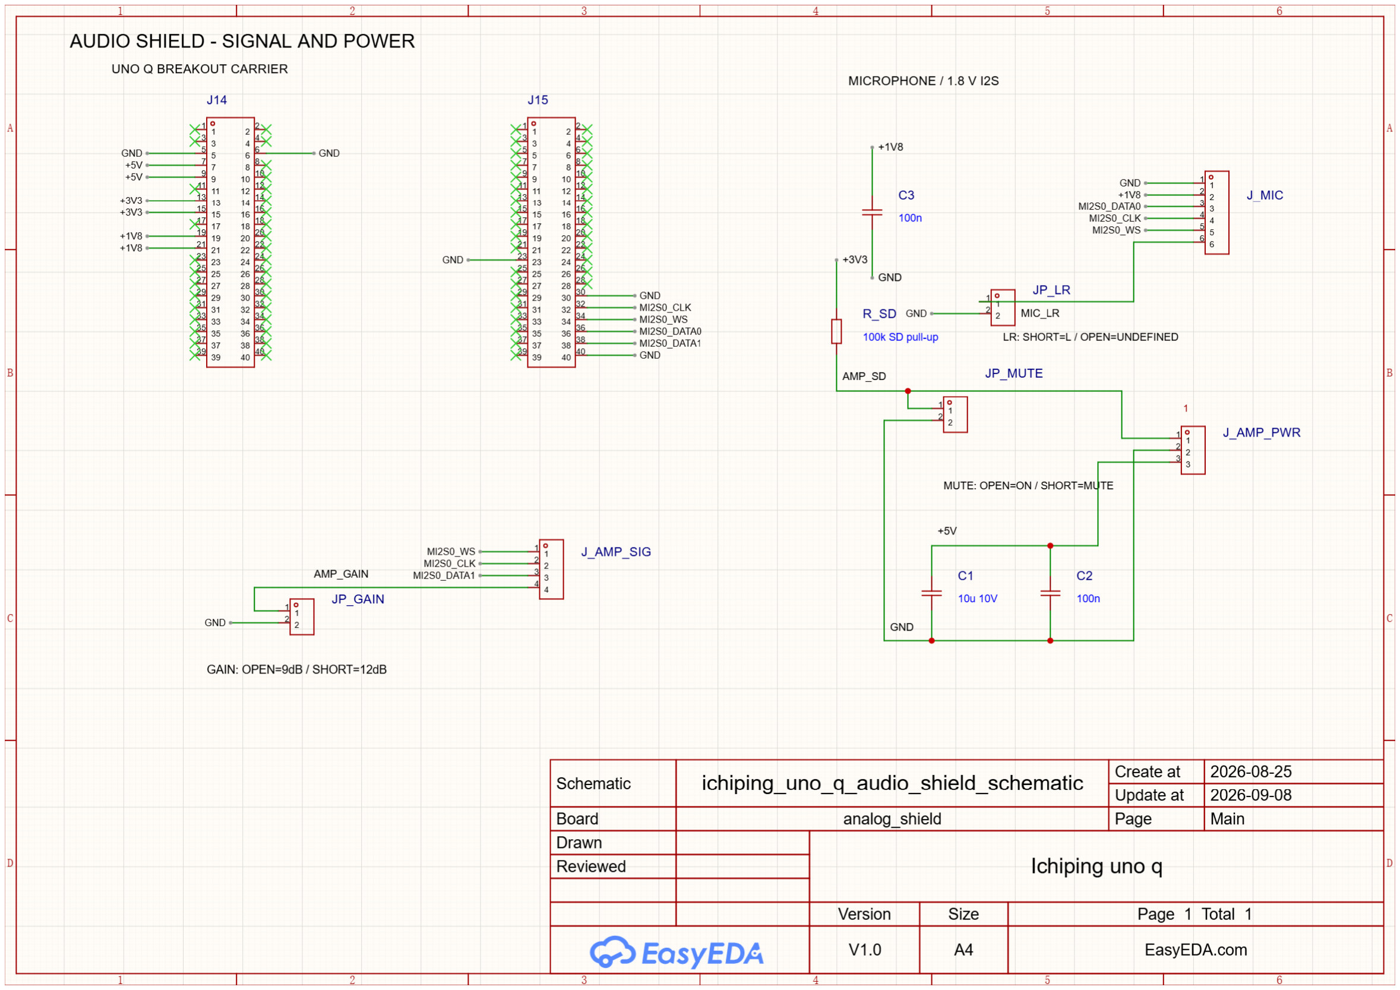
[picture p11: page 1]
