airpocket-soundman/IchiPing-UNO-Q/output/pdf/uno-schematic-after.pdf

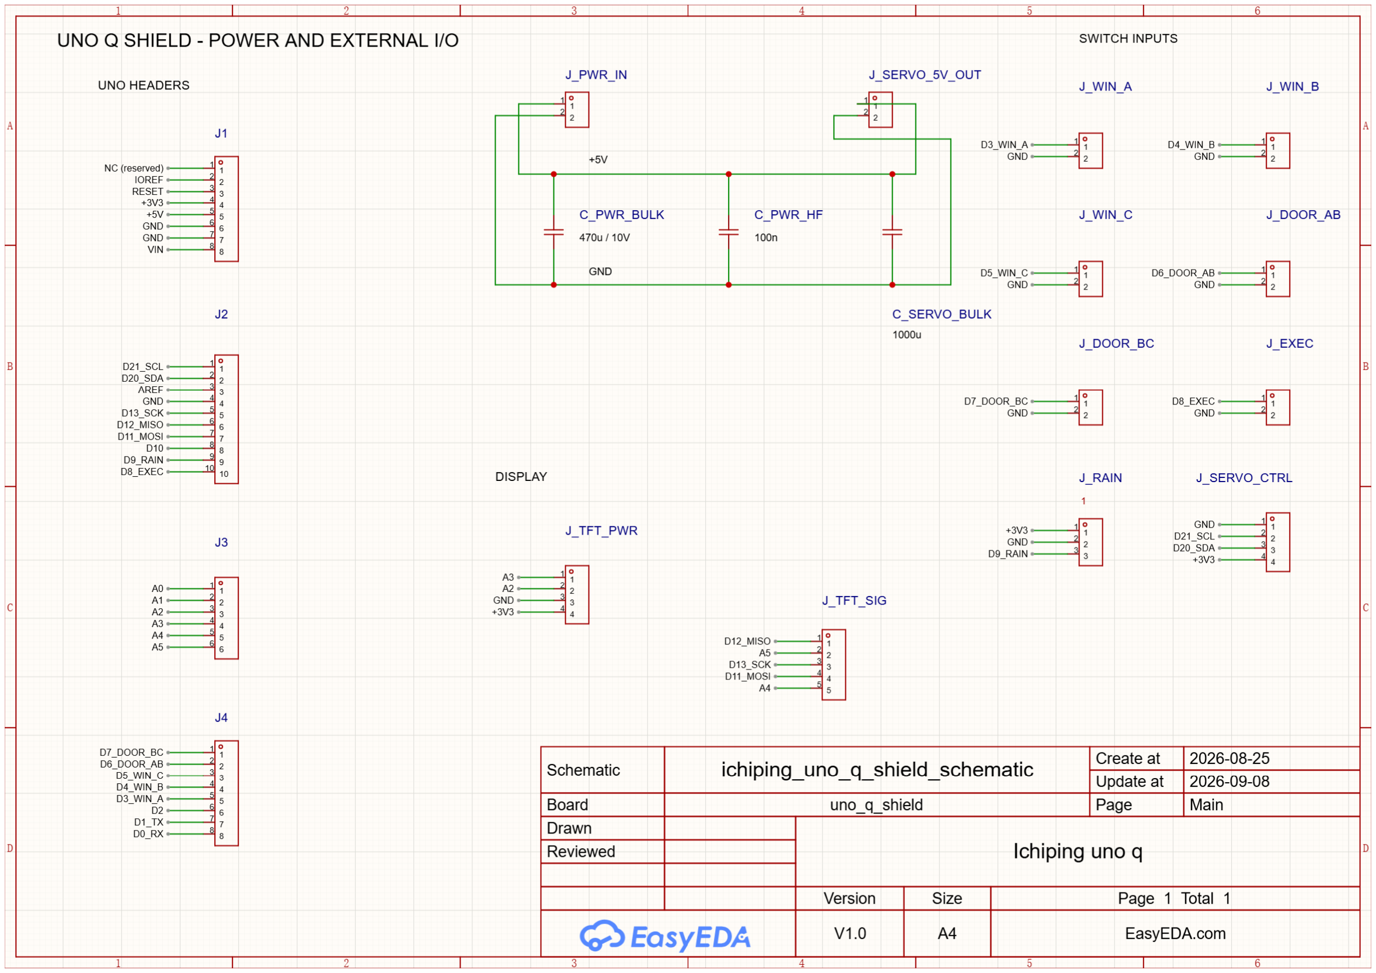
[picture p12: page 1]
