airpocket-soundman/IchiPing-UNO-Q/board/PCB_analog_shield_2026-09-13.png

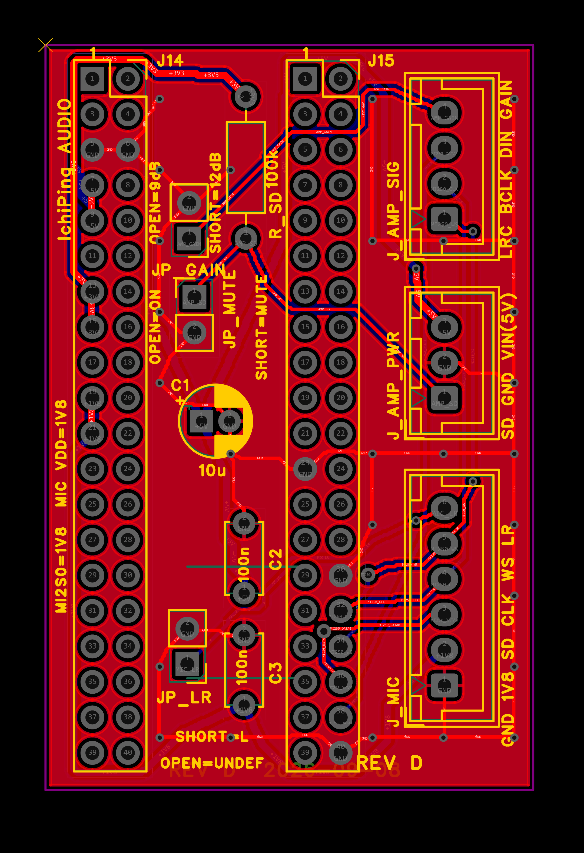
board/PCB_analog_shield_2026-09-13.png
