airpocket-soundman/IchiPing-UNO-Q/board/PCB_uno_q_shield_2026-09-13.png

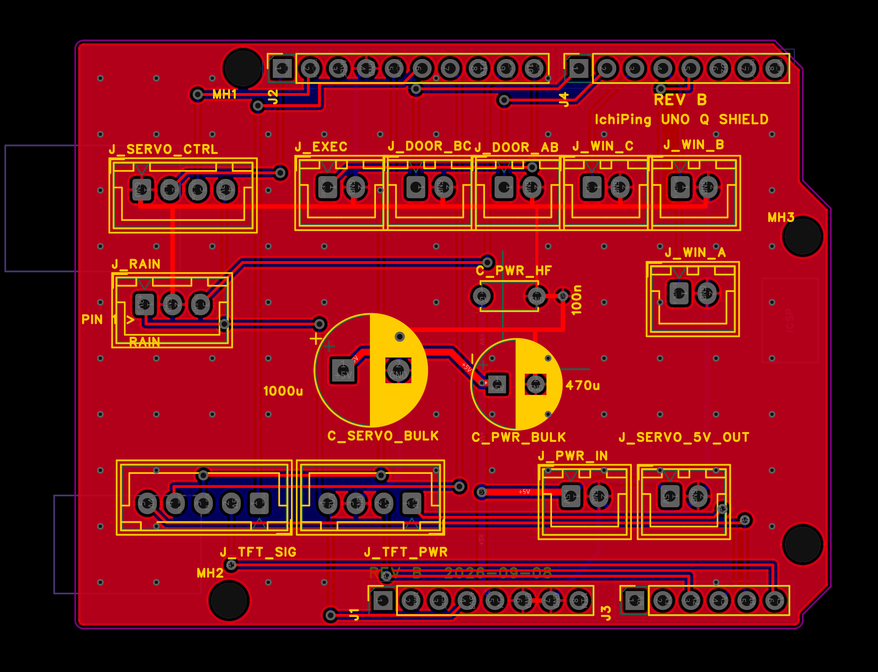
board/PCB_uno_q_shield_2026-09-13.png
