airpocket-soundman/IchiPing-UNO-Q/board/SCH_ichiping_uno_q_shield_schematic_1-Main_2026-09-13.png

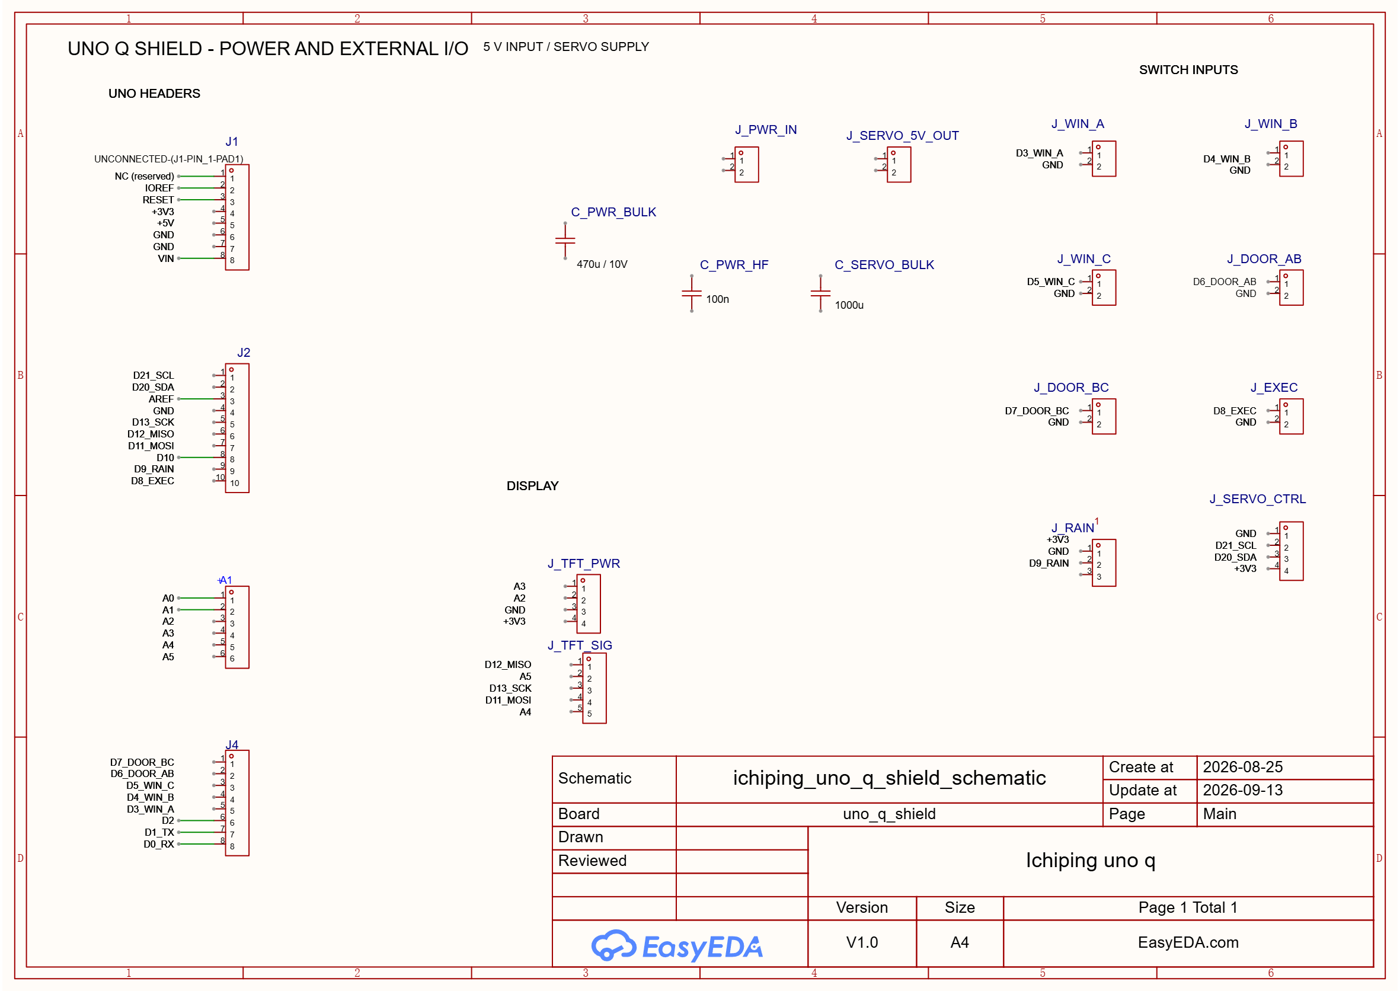
board/SCH_ichiping_uno_q_shield_schematic_1-Main_2026-09-13.png
