airpocket-soundman/IchiPing-UNO-Q/docs/img/hackster_cover_uno_ping.jpg

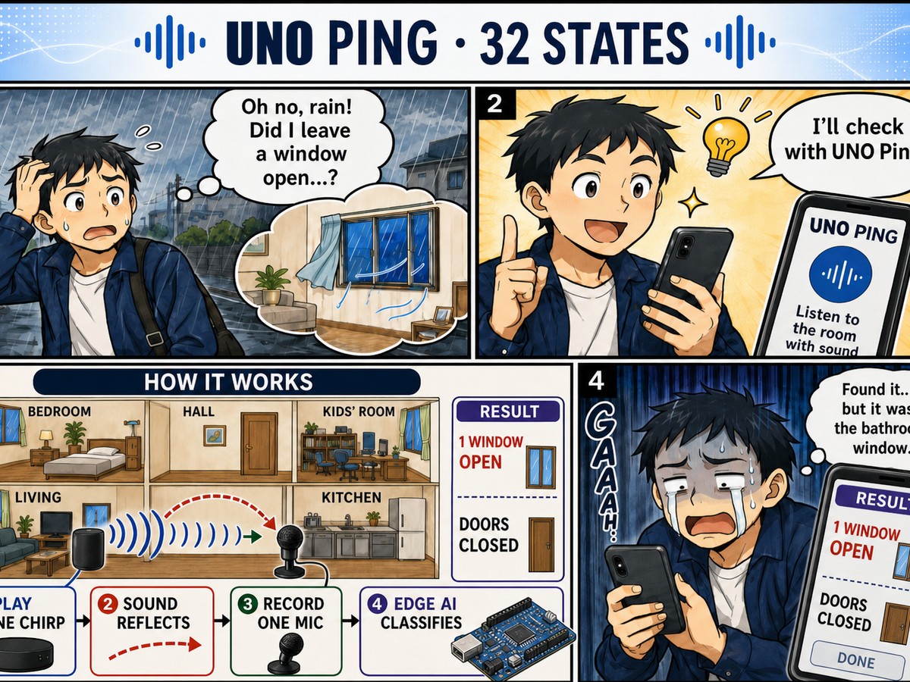
docs/img/hackster_cover_uno_ping.jpg
