airpocket-soundman/IchiPing-UNO-Q/docs/img/house_model_front.jpg

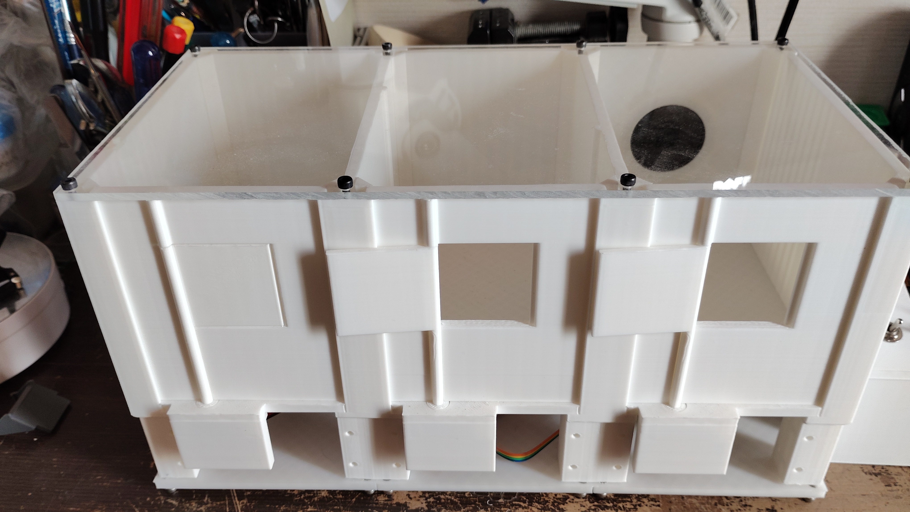
docs/img/house_model_front.jpg
