airpocket-soundman/IchiPing-UNO-Q/docs/img/house_model_overview.jpg

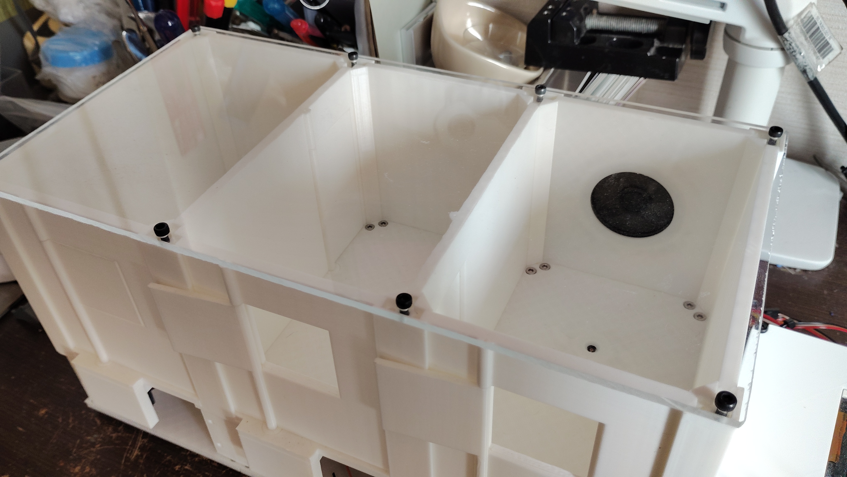
docs/img/house_model_overview.jpg
