airpocket-soundman/IchiPing-UNO-Q/docs/img/house構造.png

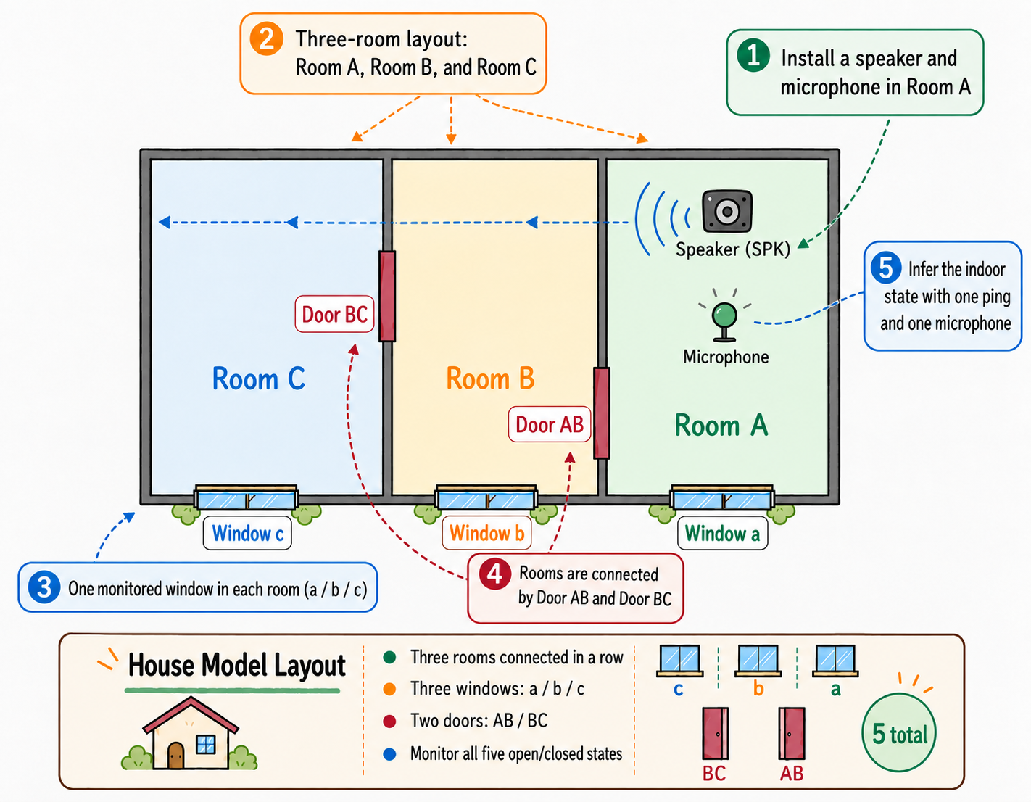
docs/img/house構造.png
