airpocket-soundman/IchiPing-UNO-Q/docs/img/ichiping_uno_q_system_overview.jpg

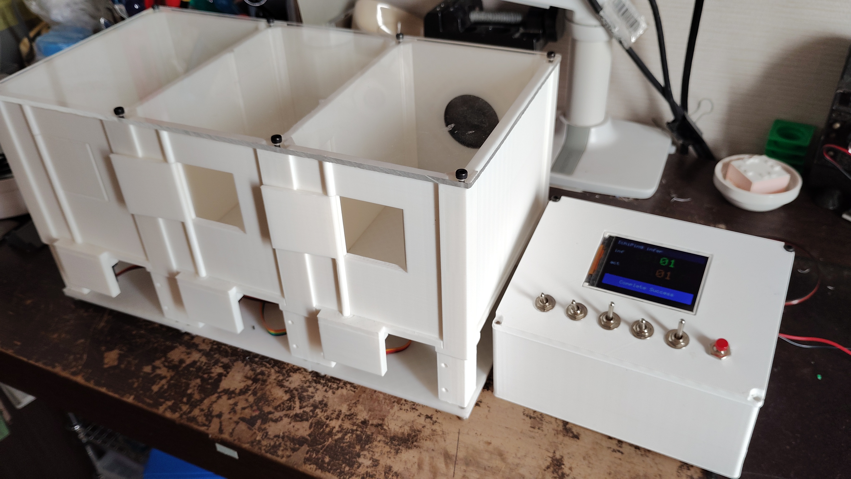
docs/img/ichiping_uno_q_system_overview.jpg
