airpocket-soundman/IchiPing-UNO-Q/docs/img/room_a_speaker_microphone.jpg

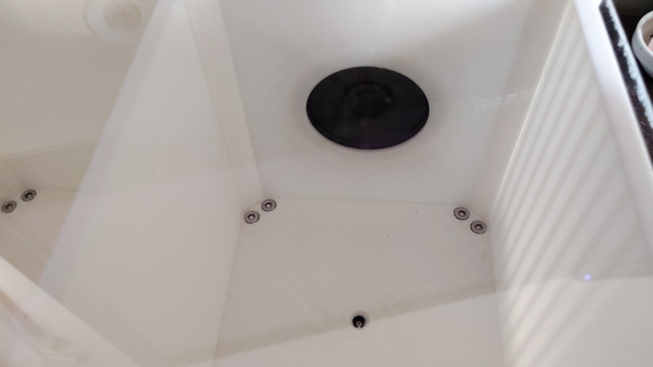
docs/img/room_a_speaker_microphone.jpg
