airpocket-soundman/IchiPing-UNO-Q/output/pdf/audio-schematic-before.png

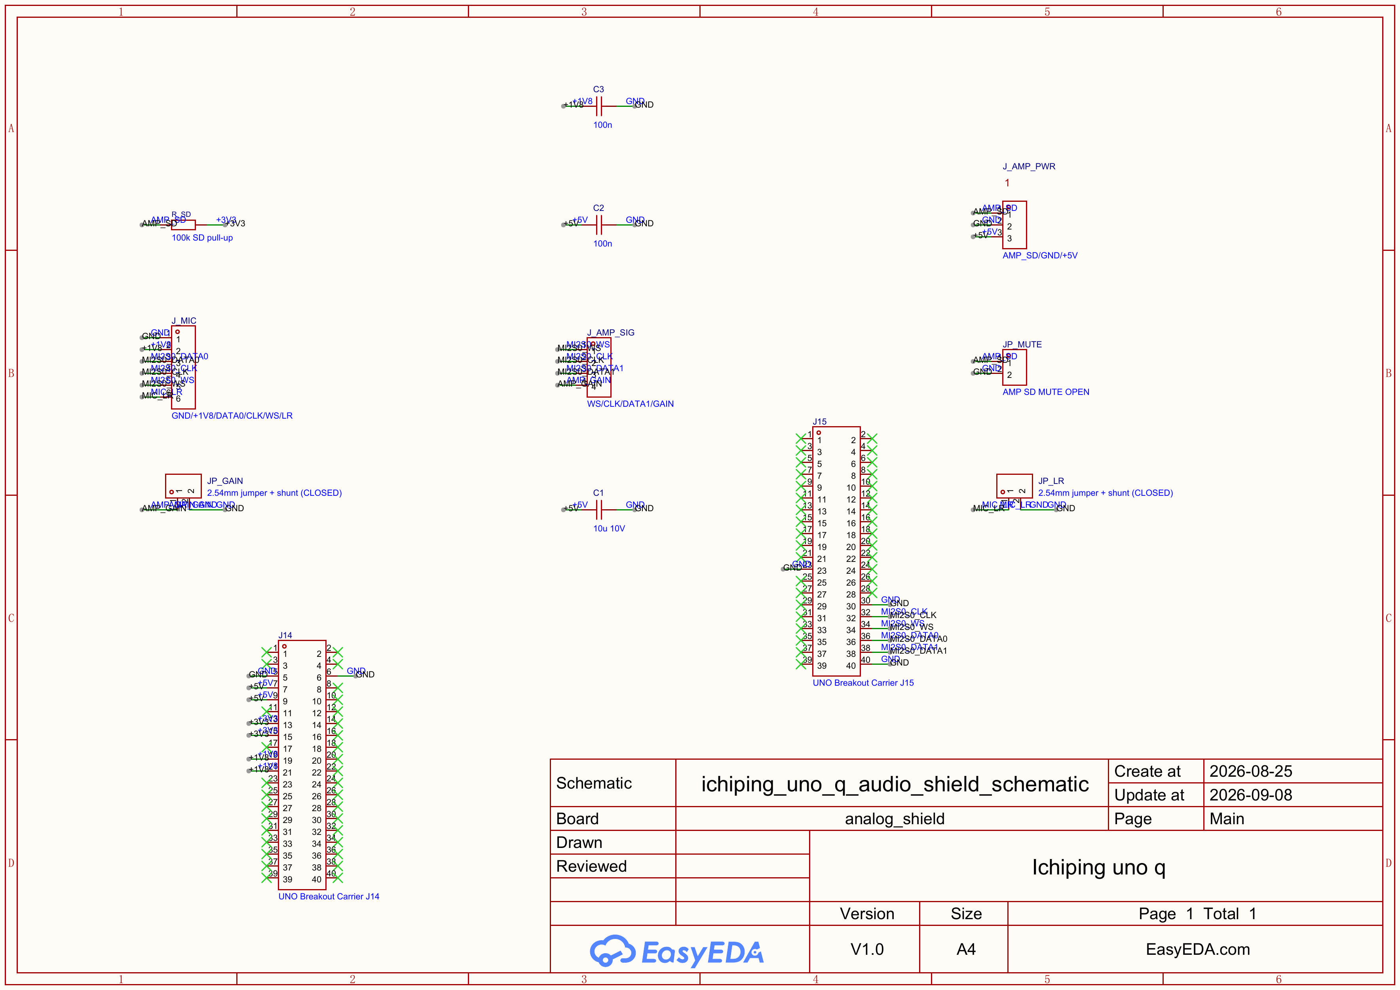
output/pdf/audio-schematic-before.png
