airpocket-soundman/IchiPing-UNO-Q/output/pdf/uno-schematic-before.png

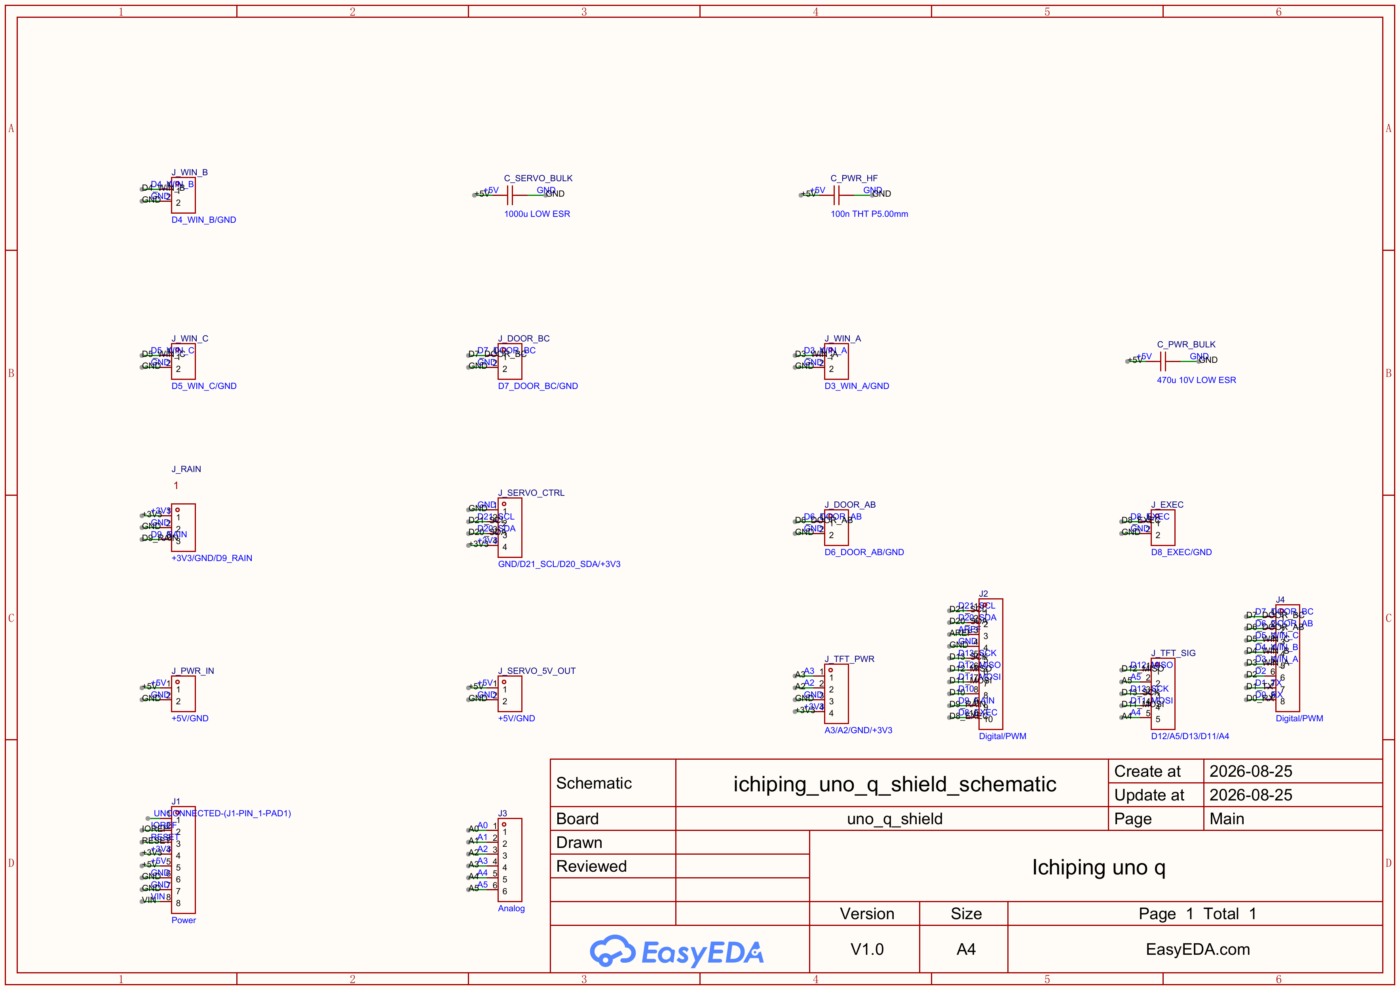
output/pdf/uno-schematic-before.png
