airpocket-soundman/IchiPing-UNO-Q/hardware/3d_parts/pillar2.stl

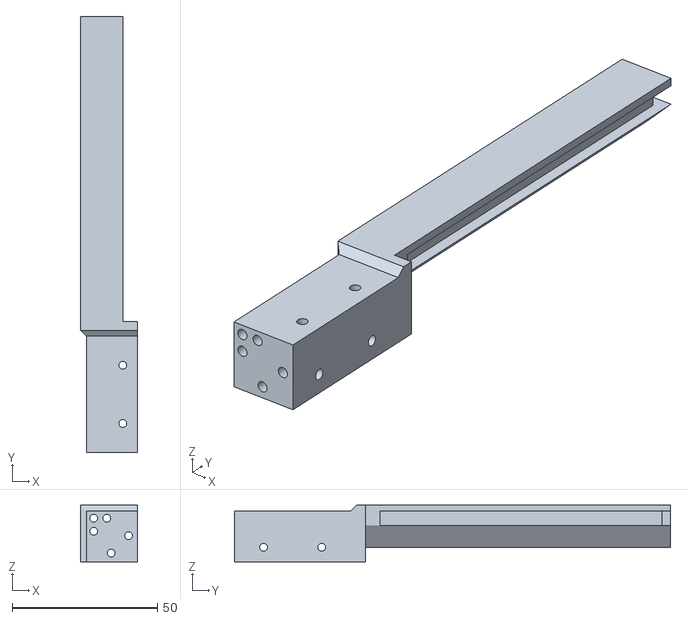
[picture p25: CAD file, 2026-09-13]
hardware/3d_parts/pillar2.stl
19.5 x 150.0 x 19.5
