airpocket-soundman/IchiPing-UNO-Q/hardware/3d_parts/pillar3.stl

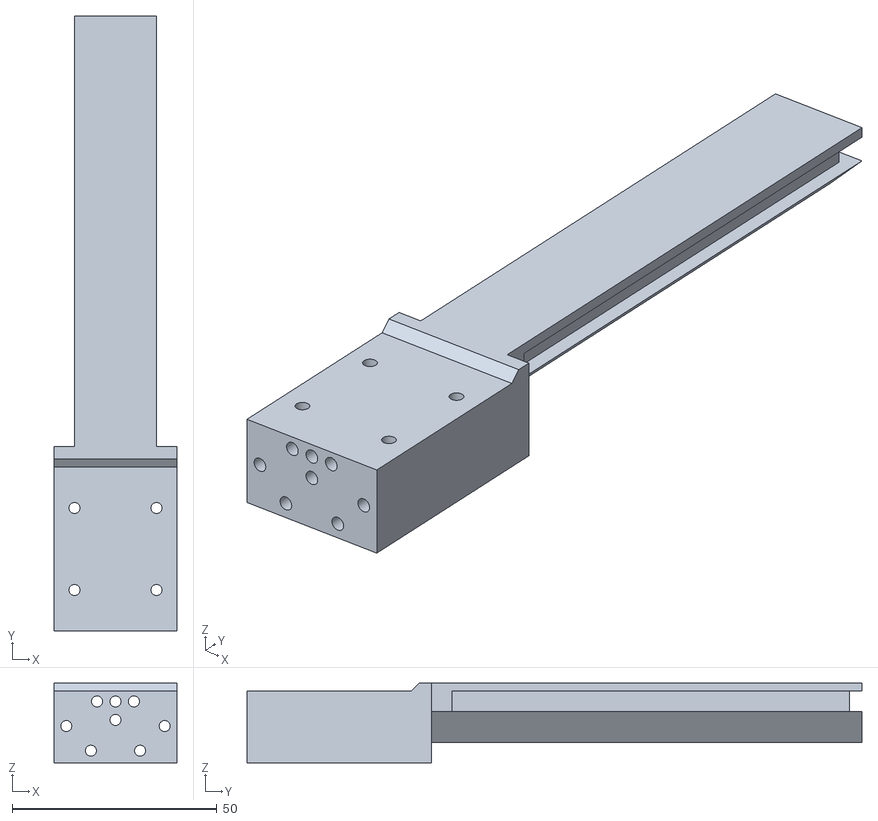
[picture p26: CAD file, 2026-09-13]
hardware/3d_parts/pillar3.stl
30.0 x 150.0 x 19.5
