airpocket-soundman/IchiPing-UNO-Q/hardware/3d_parts/wall 150.stl

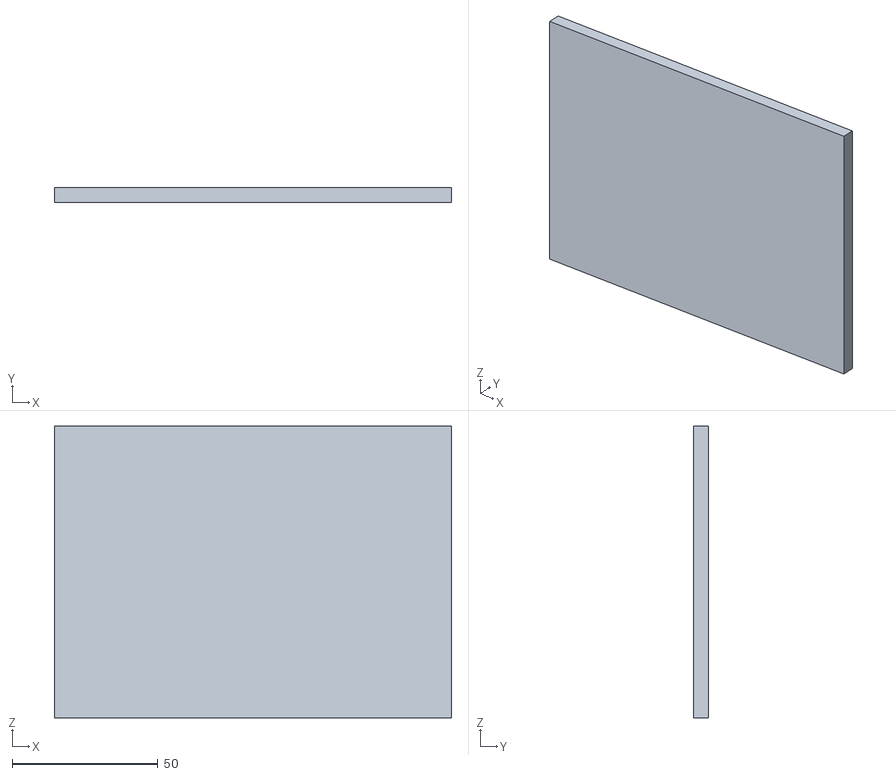
[picture p27: CAD file, 2026-09-13]
hardware/3d_parts/wall 150.stl
136.0 x 5.00 x 100.0
