airpocket-soundman/IchiPing-UNO-Q/hardware/3d_parts/ceiling2.stl

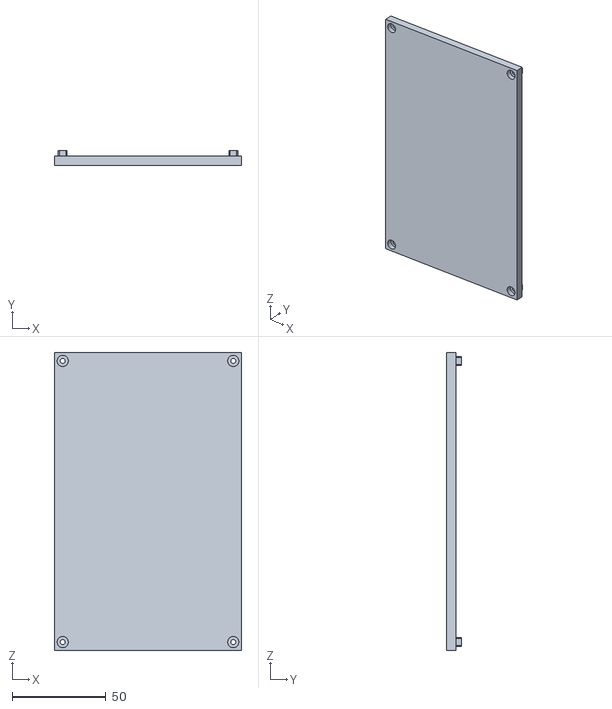
[picture p28: CAD file, 2026-09-13]
hardware/3d_parts/ceiling2.stl
100.0 x 7.80 x 159.0
