airpocket-soundman/IchiPing-UNO-Q/hardware/3d_parts/door.stl

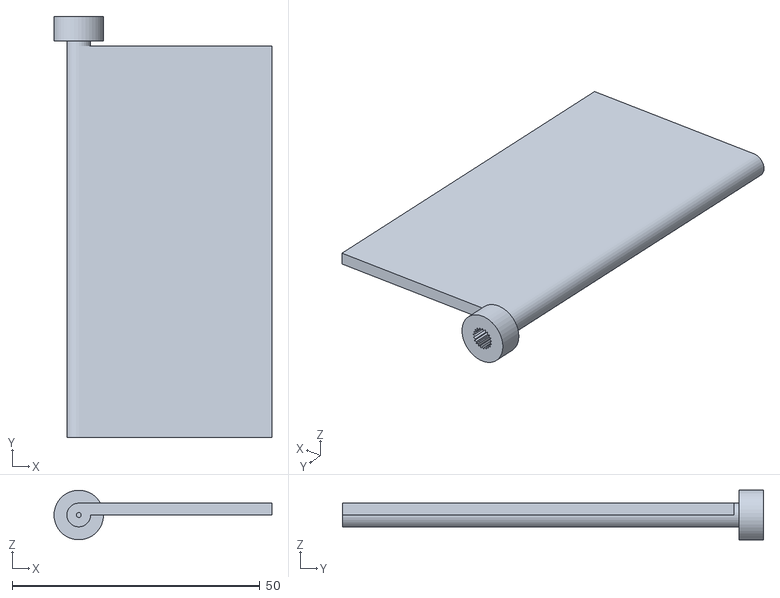
[picture p29: CAD file, 2026-09-13]
hardware/3d_parts/door.stl
44.0 x 85.0 x 9.99
