airpocket-soundman/IchiPing-UNO-Q/hardware/3d_parts/wall 150 door.stl

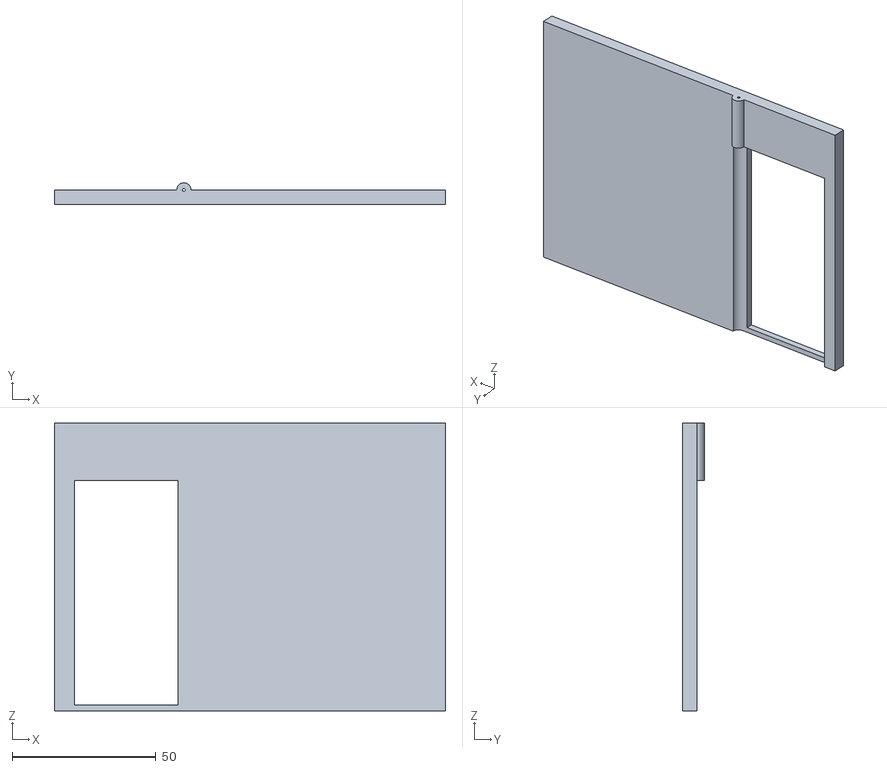
[picture p30: CAD file, 2026-09-13]
hardware/3d_parts/wall 150 door.stl
136.0 x 7.50 x 100.0
