airpocket-soundman/IchiPing-UNO-Q/hardware/3d_parts/mic holder.stl

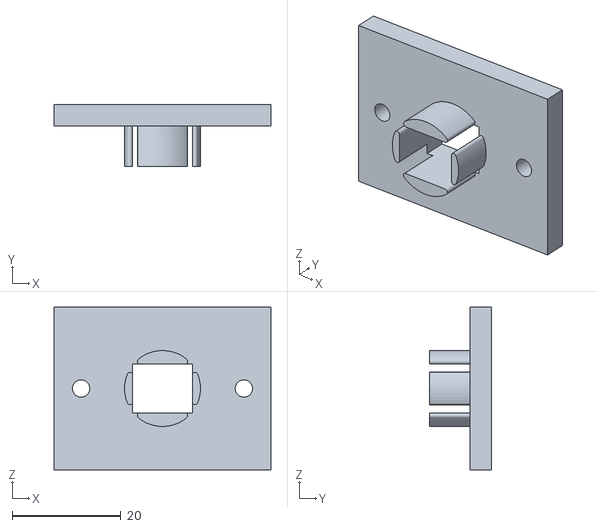
[picture p31: CAD file, 2026-09-13]
hardware/3d_parts/mic holder.stl
40.0 x 11.5 x 30.0
