airpocket-soundman/IchiPing-UNO-Q/hardware/3d_parts/floor1.stl

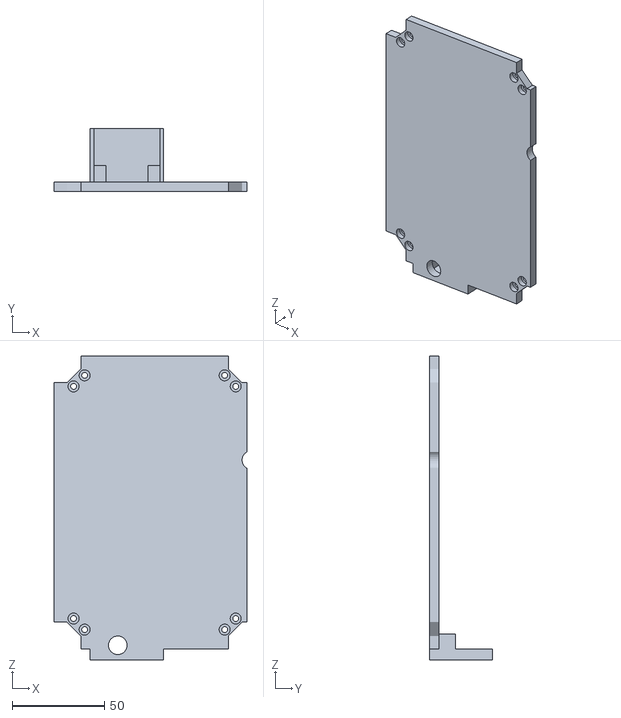
[picture p32: CAD file, 2026-09-13]
hardware/3d_parts/floor1.stl
104.5 x 34.0 x 165.0
