airpocket-soundman/IchiPing-UNO-Q/hardware/3d_parts/floor3.stl

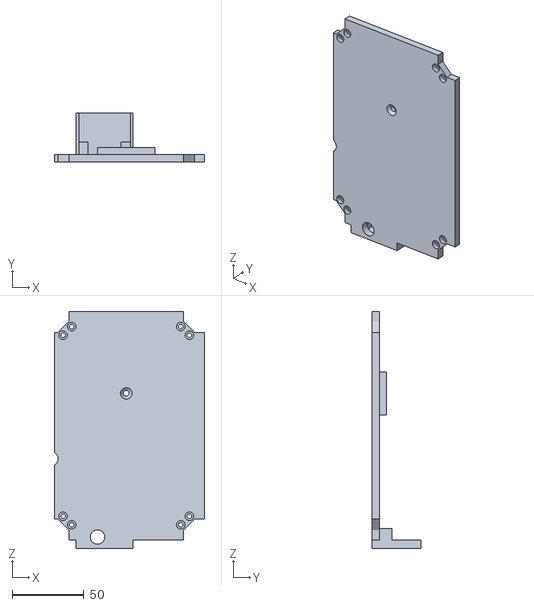
[picture p33: CAD file, 2026-09-13]
hardware/3d_parts/floor3.stl
104.5 x 34.0 x 165.0
