airpocket-soundman/IchiPing-UNO-Q/hardware/3d_parts/speaker holder.stl

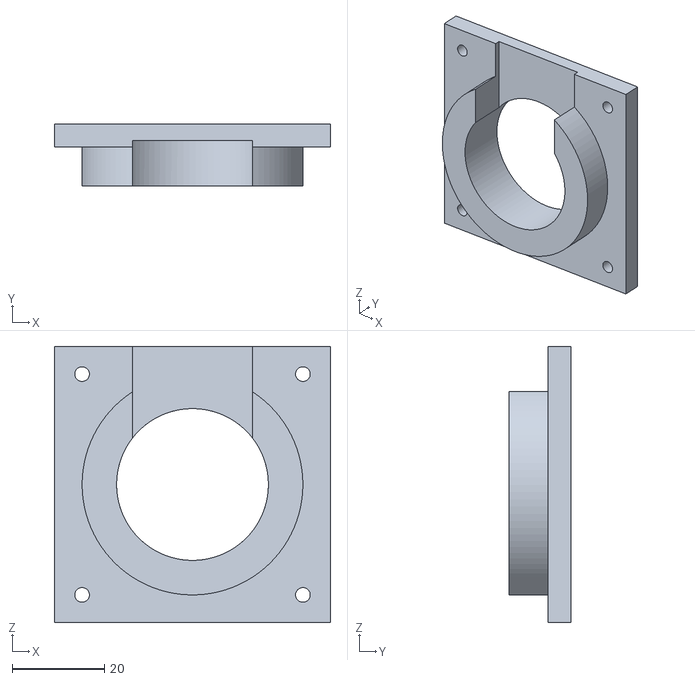
[picture p34: CAD file, 2026-09-13]
hardware/3d_parts/speaker holder.stl
60.0 x 13.5 x 60.0
