airpocket-soundman/IchiPing-UNO-Q/hardware/3d_parts/ceiling1.stl

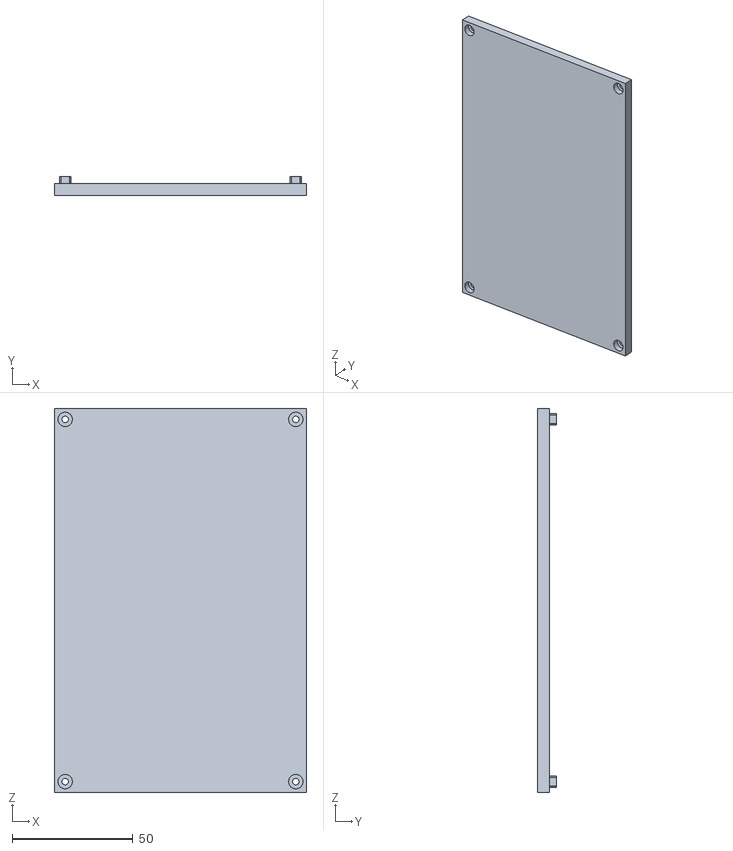
[picture p35: CAD file, 2026-09-13]
hardware/3d_parts/ceiling1.stl
104.5 x 7.80 x 159.0
