airpocket-soundman/IchiPing-UNO-Q/hardware/3d_parts/window.stl

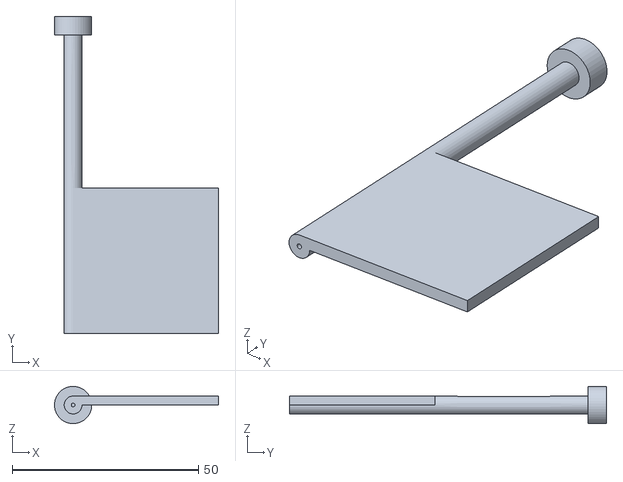
[picture p36: CAD file, 2026-09-13]
hardware/3d_parts/window.stl
44.0 x 85.0 x 9.99
