airpocket-soundman/IchiPing-UNO-Q/hardware/3d_parts/wall 100.stl

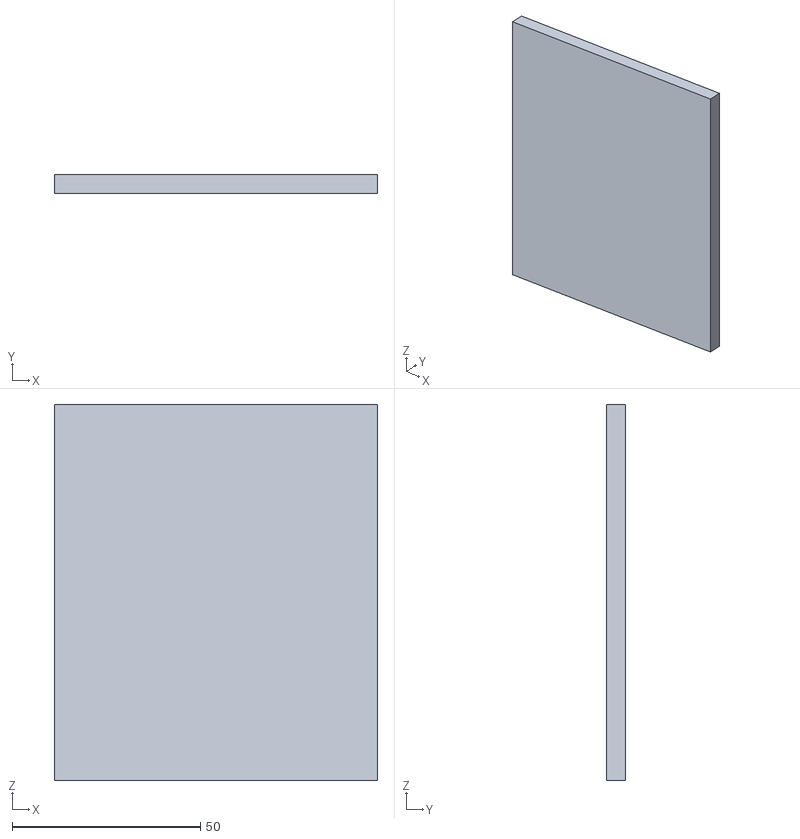
[picture p37: CAD file, 2026-09-13]
hardware/3d_parts/wall 100.stl
86.0 x 5.00 x 100.0
