airpocket-soundman/IchiPing-UNO-Q/hardware/3d_parts/wall 100 speaker.stl

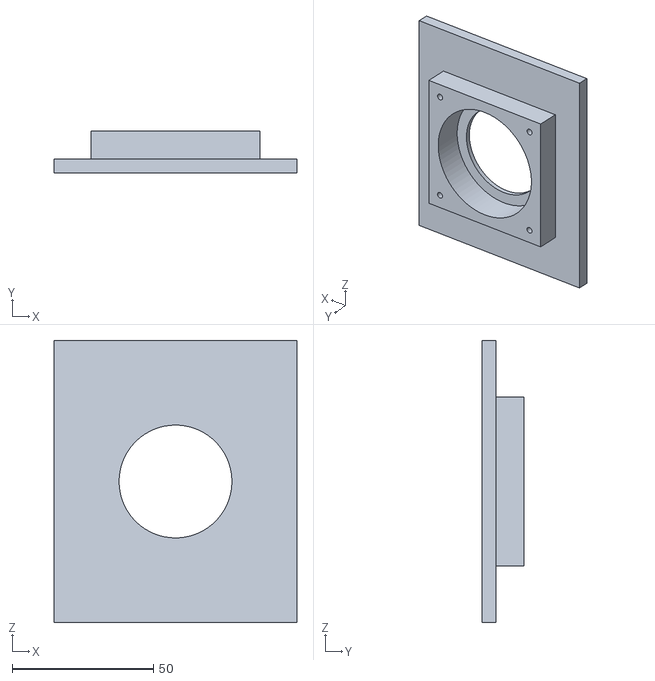
[picture p38: CAD file, 2026-09-13]
hardware/3d_parts/wall 100 speaker.stl
86.0 x 15.0 x 100.0
