airpocket-soundman/IchiPing-UNO-Q/hardware/3d_parts/floor2.stl

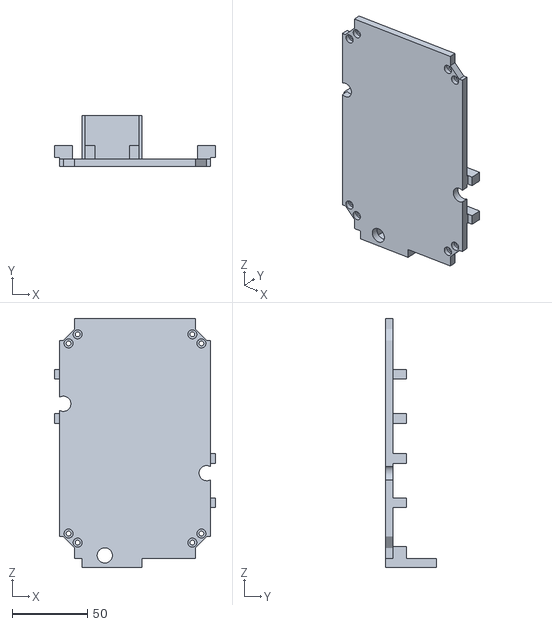
[picture p39: CAD file, 2026-09-13]
hardware/3d_parts/floor2.stl
107.0 x 34.0 x 165.0
