airpocket-soundman/IchiPing-UNO-Q/hardware/3d_parts/wall 100 window.stl

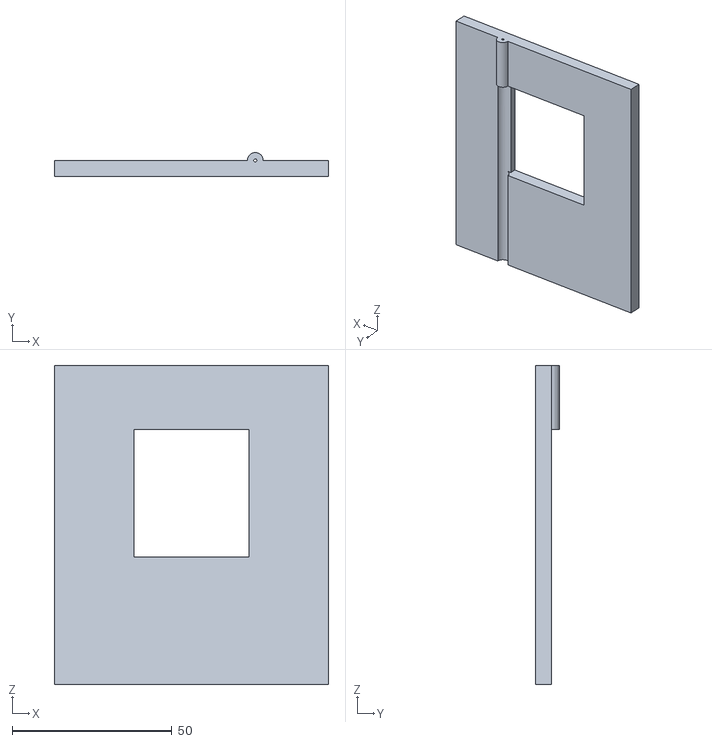
[picture p40: CAD file, 2026-09-13]
hardware/3d_parts/wall 100 window.stl
86.0 x 7.48 x 100.0
