airpocket-soundman/IchiPing-UNO-Q/docs/gpio_wiring.html

← IchiPing UNO Q / 移植方針・GPIO表

# GPIO接続図

状態スイッチ、EXEC、PCA9685、外部ILI9341 TFT、INMP441マイク、MAX98357Aアンプとスピーカーまでを示す全体接続図です。D9は予約・未使用で、雨検知は実装しません。オンボードLED Matrixは使用しません。

## 表示・マイク・スピーカー接続

GPIO / I²C信号 3.3 V 外部5 Vサーボ電源 共通GND 基板内蔵 MI2S0接続候補・未検証

## 接続一覧

UNO Q | 接続先 | 設定・意味
D3–D7 | 状態スイッチ5個の各片側。反対側はGND | INPUT_PULLUP、Low=閉、High=開
D8 | EXECボタンの片側。反対側はGND | INPUT_PULLUP、Low=押下
D9 | 接続なし | 予約・未使用。スケッチで初期化・読み取りを行わない
D20 / SDA | PCA9685 SDA | I²C、アドレス0x40
D21 / SCL | PCA9685 SCL | bring-up時100 kHz
3V3 | PCA9685 VCC | ロジック電源だけに使用
GND | 全スイッチ、PCA9685、外部5 V電源 | 全系統で共通化
D11 / D13 | ILI9341 MOSI / SCK | SPI2、3.3 V、20 MHz開始
A2 / A3 / A4 / A5 | ILI9341 CS / RST / DC / BL | 元IchiPingシールドと同じ3.3 V GPIO配線。VCC=3V3、GND共通、D12/MISOは未接続
内蔵LED Matrix | 接続なし | 不使用
MI2S0 CLK / WS | INMP441 SCK/WSとMAX98357A BCLK/LRCで共有 | GPIO98/99、1.8 V。J15-32/34またはJMISC-46/48
MI2S0 DATA0候補 | INMP441 SD | GPIO100、J15-36またはJMISC-50。Linux capture route確定後に接続
MI2S0 DATA1候補 | MAX98357A DIN | GPIO101、J15-38またはJMISC-52。Linux playback route確定後に接続
外部1.8 V LDO | INMP441 VDD | MI2S出力をQRB2210の1.8 V I/Oへ整合
外部5 V | MAX98357A VIN | アンプ電源。スピーカーはSPK+とSPK−間へ接続

サーボ電源: PCA9685のVCCは3.3 Vですが、V+とSG90は外部5 Vです。VCCとV+を混同しないでください。

MI2S0は接続候補: GPIO98–101は1.8 V専用です。DATA0/1のcapture/playback方向、Device Treeのcodec DAI、ALSA routeを確認するまではINMP441/MAX98357Aを接続・通電しません。3.3 Vや5 VのI²S信号を直接入力しないでください。

安全な接続順: 最初はサーボと外部5 Vを外し、スイッチ入力とPCA9685の0x40検出だけを確認します。次に共通GNDを再確認し、SG90を1台ずつ接続します。

公式資料: UNO Q datasheet (https://docs.arduino.cc/resources/datasheets/ABX00162-ABX00173-datasheet.pdf) / UNO Breakout Carrier datasheet (https://docs.arduino.cc/resources/datasheets/ASX00085-datasheet.pdf)
