airpocket-soundman/IchiPing-UNO-Q/uno_q/audio/HANDOFF_SCOPE_TEST.md

# 発音不良の検証まとめ・別環境での実験計画

更新: 2026-09-11 JST。**次環境はアンプ・マイク・オシロあり、ロジアナなし**。
最初にこの文書を読み、詳細は[信号監査記録](reports/2026-09-11-i2s-signal-audit.md)を参照する。

## 1. 現在地：SD制御後の短時間サイン再生に合格

2026-09-11にGPIO28のSD_MODE配線とDevice Tree制御を実装し、0.5秒の生成サイン波が
きれいに聞こえ、発音が0.5秒で停止することをユーザーが確認した。
通常試験の強制再起動は解除済みで、終了・シグナル・エラー時はプロセス停止、
route off/verify、SD Low、LED消灯を行う。過去の無負荷データ一致だけを音質合格としたのではない。

アンプ・マイクは元IchiPingで動作実績あり（ユーザー確認）。優先調査対象はUNO Q側の開始停止制御・電圧/GND・シールド経由の接続。UNO Q本体の故障、アンプ不良、単一原因はいずれも未確定。

| 区分 | 結果・扱い |
|---|---|
| 確認済み | 無負荷の再生単独／再生＋録音ともBCLK約3.072 MHz、WS約48 kHz、32 bit×2ch |
| 確認済み | 440 Hz基準PCMは左右各24,000サンプルが完全一致。負値も一致。先行ゼロによる時刻曖昧性は監査記録参照 |
| 確認済み | 再生単独ではWSの最後の変化後もBCLKが約1.2–1.4 ms継続。開始時もBCLK先行約4 ms |
| 確認済み | 同時録音中はWSを維持。最後のWS→BCLKは9.28 µsで通常半フレーム以内。単独再生の長いWS停止と区別する |
| 確認済み | GPIO28＋外付け10 kΩのSD制御。アンプ接続・スピーカー切離しでLow/HighとPCM開始停止連動を確認 |
| 確認済み | スピーカー接続後、生成サイン波の聴感が良好で、0.5秒で停止。通常試験の強制再起動を解除 |
| 別の未解決問題 | 再起動後、音声クロック取得失敗でALSAカードが現れないことがある |
| 未確認 | アンプ入力端の負荷時リンギング、マイク録音品質、左右別データ、任意周波数 |
| 過去の測定 | 強制再起動方式ではBCLK実測継続が単独約0.62秒、同時録音約1.02秒だった。現行の通常試験には適用しない |

前回の16ch/トリガー付きロジアナ記録の異常は、4ch/トリガーなしで消えた。UNO Qのビット欠落と断定しない。別環境でロジアナなしに全PCM一致を再検証したことにはしない。

## 2. 引き継ぐ実装・再現条件

- リポジトリ: `airpocket-soundman/IchiPing-UNO-Q`。元IchiPingは変更しない。
- 試験ログイン: `airpocket`。sudoグループ所属・認証済み実績あり。パスワードはGitに記録しない。別PCのADBは`arduino`ユーザーになるので、同一ユーザーと思い込まない。
- 測定対象serial: `2261748543`。別個体の場合は識別と実装版を照合し、同一結果を前提にしない。
- kernel: `6.16.7-g0dd6551ae96b`、ALSAカード: `Arduino-Imola-IchiPing-MI2S0`。
- sm8250 module SHA256: `d483125499439612381e56ac0c9a1bafe433f1680de528d546f16177dc3a507a`。
- q6asm-dai module SHA256: `c4292c7c9504c7aa01a94cd0007b86213def67a1d4a8123dd23be3ff92653526`。
- GPIO98=BCLK、GPIO99=WS、GPIO101=アンプDIN、GPIO100=マイクSD。**標準UNOのD番号ではない**。対応コネクタは[音声README](README.md)と正本 `docs/uno_q_port.html` を照合。
- 48 kHz / stereo / S32_LE（上位24bit）。GAIN=GNDは12 dB。
- 参照生成: `py -3 uno_q/audio/instrument-analysis.py prepare <新しいフォルダ>`（Windows）。Linuxは`python3`。
- 生成sine.raw: 500 ms、100 ms先行ゼロ＋100 ms 440 Hz＋300 ms後続ゼロ、5 msフェード、0.01%FS以下。非常に小さい信号なので「聞こえない」をデータ不良と即断しない。振幅増加は安全確認後の別試験として記録。
- 診断モード: `instrument-playback FILE`は再生のみ、`instrument-duplex FILE`は再生RUNNING後100 ms待って録音。双方とも識別照合・PCM検証、EXIT/シグナル/エラー時のroute off/verify・SD Lowを行う。通常試験は強制再起動しない。生成サイン波はスピーカー接続状態で聴感と0.5秒停止を確認済み。

生SR/CSV/RAWは大きいため`uno_q/audio/local-runs/`に保存しGit対象外。今回の生記録はこのPCの`D:/github/airpocket-soundman/IchiPing-UNO-Q/uno_q/audio/local-runs/instrument-prep-20260911-01/`。別環境へのpullだけでは取得されない。必要ならこのフォルダを別途コピーする。要約・解析ツール・試験コードは本コミットに含む。

## 3. 別環境で最初に行うこと

1. ボード識別、kernel/module、実行中アプリ、実際の配線・電源を確認。サーボは動かさない。
2. アンプを無効化できる手段を確保するまで、音声試験を自動再開しない。配線変更は電源OFFで実施。未給電アンプ/マイクに信号線だけ接続しない。
3. オシロの型番、チャンネル数、帯域、メモリ長、同時取得時サンプルレート、プローブ倍率、DC結合、補償・電圧校正を記録。
4. 以前のOWON API測定はレンジによる電圧不整合があった。別環境でも同じ機材/APIなら、既知電圧と補償信号で各使用レンジを確認してから電圧値を信用する。未解決なら公式アプリまたは検証済み測定手段を使う。
5. 2chオシロを基本とし、以下の組合せを同一条件で繰り返す。4信号同時取得やI²Sデコード機能は前提にしない。別々の試行の波形を単一イベントの同時測定として扱わない。

## 4. 対策を実装してから比較する

### SD制御（GPIO28で実装・電気確認済み）

2026-09-11追記: GPIO28（UNO Breakout CarrierのSOC_GPIO_28 / JMISC pin 51）と
外付け10 kΩプルダウンで実装し、アンプ接続・スピーカー切離しでHigh/Low、
実機boot、ゼロPCM開始停止連動まで確認した。詳細は
[SDMODE_GPIO28.md](SDMODE_GPIO28.md)。以下の一般要件は音響試験でも維持する。

実物モジュールのSDプルアップ/プルダウンと電圧を確認し、空きGPIOとレベル適合を決める。GPIO番号や抵抗値を推測で指定しない。必要ならトランジスタ/オープンドレイン回路を介し、GPIOリセット・高インピーダンス時もアンプ無効になる構成にする。SDのバイアスはチャンネル選択にも関係するので、有効時の選択モードも記録する。

- 開始: アンプ無効を維持 → ゼロPCMでBCLK/WS/DATAを安定 → アンプ有効 → フェード付きサイン/後でchirp。
- 停止: ゼロPCM → アンプ無効 → クロック停止。
- 固定sleepだけで順序成立と見なさず、オシロで実際のSD・WSを確認する。
- 例外・PCM underrun・停止要求・電源断の扱いも維持する。通常試験は再起動せず、終了処理でSD Lowまで検証する。

常時ゼロPCMでクロックを維持する方式は、頻繁な開始停止を減らす別案。ただしプロセス異常時のSD停止が別途必要。SD対策とストリーム方式を同時に変更せず、どの変更が改善したか分かる順に試す。

## 5. オシロを使う順序と判定

| 試験 | 外部ボード・オシロ接続 | 見るもの／次へ進む条件 |
|---|---|---|
| A1：無負荷クロック | アンプ・マイクなし。CH1=BCLK、CH2=WS | 対策後も約3.072 MHz/48 kHz。開始・停止を長時間窓、定常部を短時間窓で別取得 |
| A2：有効化順序 | アンプ未接続のSD制御点。CH1=SD、CH2=WS | 開始/停止ともSDの有効化がWSの安定区間内に収まる。エッジ順が曖昧なら停止 |
| A3：補助確認 | CH1=SD、CH2=BCLK | BCLKだけ動く区間でアンプ有効にならないこと。A2と同一条件で繰返す |
| B1：負荷時入力 | アンプのみ接続、SD無効、スピーカーなし。CH1=BCLK、CH2=WS。次にCH1=BCLK、CH2=DIN | アンプ端でHigh≥1.3 V、Low≤0.6 Vを測定誤差込みで確認。オーバーシュート/リンギング/共通GNDを確認 |
| B2：電源・SD | アンプ接続。CH1=SD、CH2=VIN、次にSD/WS | 電源投入・起動・停止で意図しない有効化や電源低下がない。SDの実電圧確認 |
| C1：ゼロPCM | 上記合格後、アンプ＋スピーカー、マイクなし | 開始/ゼロ送信中/停止のノイズを独立録音と聴取で区別。持続ノイズなら即中止 |
| C2：サインPCM | 同じ配線で微小サイン。独立録音器を固定位置に置く | 440 Hzが観測され、開始/停止ノイズと定常ノイズを分けて評価。以前の危険な停止方式を再現して比較する必要はない |
| D：マイク追加 | 電源OFFでマイク追加。再生のみ→再生＋録音を比較 | アンプ端BCLK/WSに変化がないか、ノイズが追加されるか。独立録音とINMP441録音を別々に評価 |

短時間窓では可能なら100 MS/s以上を実際の2ch設定で確認する。25 MHz級オシロでは周期や大きな波形崩れは見られても、10 nsセットアップ/ホールドや細かなジッタを完全保証できない。長時間窓の低サンプルレートでBCLK振幅/形状を判定しない。全PCM一致は今回のロジアナ測定の範囲だけで主張する。

**スピーカー出力はBTL。OUT+またはOUT−へ通常プローブのGNDクリップを接続しない。** 出力差動測定が必要なら適切な差動プローブ、または両GNDを回路GNDに接続した2ch差分を、各入力の定格/同相範囲/接地を確認して使う。USB絶縁がチャンネル間絶縁を意味するとは限らない。Class-DのPWM波形をそのまま音声波形と解釈しない。

## 6. 中止条件と記録

- SD順序不成立、予期しない連続音、異常発熱、電源不安定、ALSAカード未初期化、測定器の校正不良では進めない。
- 異常時はまず独立したアンプ無効化/電源遮断手段を使う。ソフト再起動の完了を待つ方式だけにしない。
- ALSAカードなしのまま音声を出そうとしない。ログを保存する。過去のADSP stop/startは無音状態での復旧実績であり、発音中の緊急停止手順ではない。
- 試験ごとに日時・Git commit・ボードserial・kernel/module hash・配線写真・接続ボード・SD回路・電源・オシロ設定・波形CSV/スクリーンショット・独立録音・期待値/実測値/判定を新しいフォルダへ保存。
- 「対策前＝今回の無負荷計測/既存発音記録」「対策後＝SD等の変更と測定」を明記。改善しなければSDだけを原因と断定せず、アンプ端信号/GND/電源を優先調査する。
- 成功は実際の発音で確認する。データ一致、ALSA正常終了、無負荷の全ゼロ録音だけでは完了にしない。

## 根拠

- [Analog Devices公式FAQ：停止前にSD無効、再有効化前にLRCLKが必要](https://ez.analog.com/audio/a/documents/do11587/dc-output-on-speaker-for-max98357)
- [メーカー・データシート](https://cdn-shop.adafruit.com/product-files/3006/MAX98357A-MAX98357B.pdf) pp.6–7、16、19：論理電圧、タイミング、停止条件。
- [Arduino使用版MAX98357ドライバー](https://github.com/arduino/linux-qcom/blob/0dd6551ae96b78024086e72339fefbef6fcc604b/sound/soc/codecs/max98357a.c)：任意のsdmode GPIO制御。
