airpocket-soundman/IchiPing-UNO-Q/docs/img/hackster_results_en.png

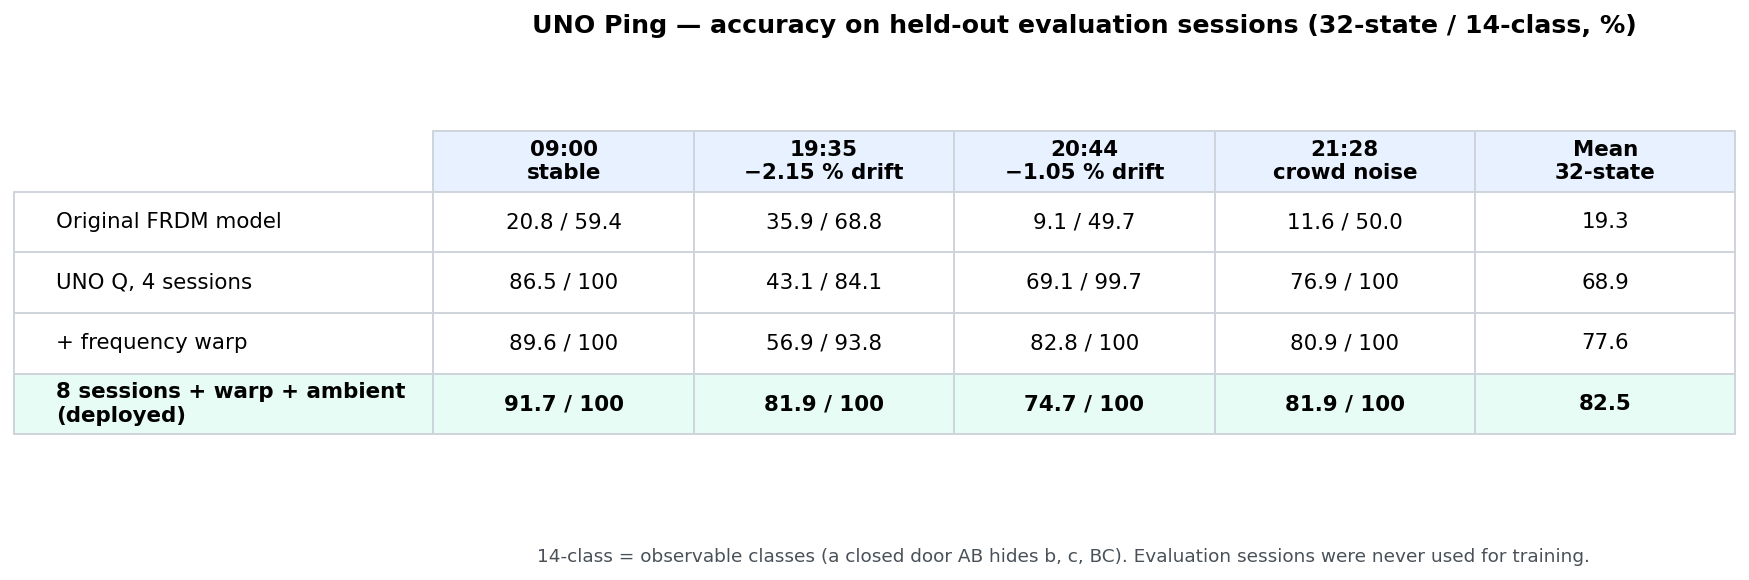
docs/img/hackster_results_en.png
