airpocket-soundman/IchiPing-UNO-Q/board/REPAIR_STATUS.md

# 2026-09-08 0Ω抵抗のジャンパ置換完了（製造未リリース）

対象は `Ichiping uno q.eprj2`。ユーザー指定に従い、退避されていたローカル版を正として修正。元のIchiPingは変更していない。

## シルク修正・版管理の追加

同日追記: 単なるOPEN/CLOSEDを機能表示に変更。JP_GAIN: OPEN=9dB / SHORT=12dB、JP_MUTE: OPEN=ON / SHORT=MUTE、JP_LR: OPEN=UNDEF / SHORT=L。JP_LR開放時のバイアス抵抗がないため左右未確定で、Rとは表示しない。45 mil文字を脇・下側へ配置し、素子配置・配線は変更せず収めた。REV Dの未リリース調整として履歴に記録。

2026-09-08: UNOをREV B、AudioをREV Dへ更新。26種類のフットプリントのカスタム層にあった部品枠を表面シルクへ戻し、文字を原則50 mil（密集部45 mil）、版番号を60 milへ拡大。表裏に版番号、裏面には日付も表示。ガーバーのシルク層から確認SVGを生成。[版管理ページ](REVISIONS.html) / [履歴](REVISIONS.md)。

両PCBのDRC0件、PCBネットリストと電気的な配置・配線定義はシルク変更前と一致。製造リリースとは区別する。

## 保存・再読込後に確認済み

- Audio J14/J15: 奇数列を上面視で左へ、偶数列を右へ修正。部品パッドの一時状態だけでなく、プロジェクト内のフットプリントを編集した。
- Audio R_GAIN/R_LR: JP_GAIN/JP_LRの2.54 mmジャンパへ置換。通常はショートピンを装着。R_SD 100 kΩは保持。
- Audioの配線を変更後の端子位置に合わせて再作成し、GNDベタを再計算。
- 既存GNDビア105個と新設信号・電源ビア4個を両面レジスト被覆に設定。層間導通用のめっき穴は維持。
- UNO PCB、Audio PCBとも `pcb_Drc.check(true, false, true)` は空配列。Audioは保存してタブを閉じ、再読込して確認した。
- Audioの新設ジャンパの穴径は1.00 mm、ピッチ2.54 mmを読戻し確認。
- 回路図のR_GAIN/R_LRもJP_GAIN/JP_LRへ置換。既存Unique IDを維持してデバイス、シンボル、フットプリントを更新し、ジャンパのピン位置に合わせて配線を延長した。
- 基板の0Rシルク2個をCLOSEDに更新。JP_GAIN/JP_LRの部品番号を正立表示に調整。
- 製造データAPIから回路図・PCBのネットリストをそれぞれ出力し、Unique ID、Designator、Device、Footprint、Name、全ピンのネットを比較。UNOは19部品70ピン、Audioは12部品107ピン、両方とも差分0件。
- 両PCBのDRCは0件。両PCBの文字図元に0R・0Ω・R_GAIN・R_LRの残存なし。
- Audio実装部品をBOM HTML、統合CSV、Audio個別CSVへ反映し、仕様書のジャンパ・SD設定も更新。

## 置換作業とは別の製造・購入確認

- J14/J15の公式Carrier資料との上面・嵌合面の最終照合が必要。DRCとネットリスト一致だけを製造可の判定にしない。
- 秋月購入表の追加部品で販売コード未選定のものは、HTML・CSVに明記。基板フットプリントへの適合を確認して選定する。
- Rev B仕様書の外形拡張案は未適用。ユーザー指定のローカル基板外形・配置を維持。
- ガーバー／ドリルの最終検査および製造リリース用のコミット・プッシュは未実施。

変更前バックアップおよびAPI読戻し・DRC結果は `.cache/pcb-repair-20260908/` に保存。これはローカル作業用で、Gitへ追加しない。元の退避stashも保持している。
