airpocket-soundman/IchiPing-UNO-Q/board/REVISIONS.md

# 基板リビジョン管理

正本はこのフォルダの `Ichiping uno q.eprj2`（EasyEDA）。原版IchiPingは変更しない。
見やすい版: [基板リビジョン・シルク確認](REVISIONS.html)。

## 現在の版 — 2026-09-08

| 基板 | PCB文書 | 旧シルク表記 | 今回の表記 | 状態 |
|---|---|---|---|---|
| UNO Q Shield | uno_q_shield / 484a25750631f0fe | REV A 2026-08-24 | REV B / 2026-09-08 | 設計検査済み・製造未リリース |
| Audio Shield | analog_shield / 86c9249a00f4733c | REV C 2026-08-25 | REV D / 2026-09-08 | 設計検査済み・製造未リリース |

両基板の表面にREV、裏面にREVと日付を印刷する。旧シルク表記は置換済み。
仕様書の「Rev B 設計入力」は過去の外形拡張案の文書番号であり、このUNO基板REV Bの適用範囲とは異なる。外形拡張案は適用していない。

## 今回の変更内容

- プロジェクト内の26種類のフットプリントで、カスタム層に置かれていた部品枠・極性マークを実際の表面シルク層へ移動。組立層と配置確認用の枠は維持。部品枠は部品に追従する。
- 文字サイズは原則50 mil（1.27 mm）、密集部は45 mil（1.143 mm）。従来の30〜31.5 milの説明・値を拡大。新版番号は60 mil（1.524 mm）。
- 文字線幅7 mil（0.178 mm）、表面新版番号8 mil（0.203 mm）、枠線6 mil（0.152 mm）以上。隣接部品の番号・容量表示の位置を調整。
- AudioのJ14/J15には1番ピンの目印を表示。ジャンパには単なるOPEN/CLOSEDでなく、次表の機能を表示。
- 今回のシルク変更では部品位置、配線、ビア、パッド、ネット、ベタ領域を変更していない。
- この版には同日実施のJ14/J15列方向修正、0Ω抵抗のジャンパ化、配線修正も含む。詳細は[修正記録](REPAIR_STATUS.md)。

## 確認結果

### ジャンパの機能表示（REV D内の未リリース調整）

| ジャンパ | シルクの開放表示 | シルクの短絡表示 |
|---|---|---|
| JP_GAIN | OPEN=9dB | SHORT=12dB |
| JP_MUTE | OPEN=ON | SHORT=MUTE |
| JP_LR | OPEN=UNDEF | SHORT=L |

GAINはMAX98357AのI²Sモードかつモジュール側に追加GAIN設定抵抗がない場合。JP_LRはシールドに開放時のプルアップ／プルダウンがなく、マイクモジュール側の設定がなければ入力が浮く。開放をRとは扱わず、通常は短絡してLを選ぶ。UNDEFは「左右未確定」。左右を開放／短絡で確実に切り替える機能は、別途回路変更が必要。

文字は45 milを維持してジャンパ脇と下側に配置。部品移動・配線変更なしで収まった。
根拠: [MAX98357A Table 8 / Shutdown](https://www.analog.com/media/en/technical-documentation/data-sheets/MAX98357A-MAX98357B.pdf)、[INMP441 L/R](https://invensense.tdk.com/wp-content/uploads/2015/02/INMP441.pdf)。

- 両PCBの厳密DRC: 0件。
- 保存済みPCBネットリストはシルク変更前と一致（UNO 19部品70ピン、Audio 12部品107ピン）。変更前に回路図との一致も確認済み。
- 両PCBの配線・ビア・パッド・部品位置・ネット割当・ベタ定義を変更前と比較し一致。
- 下記SVGはEasyEDAの実際のガーバー・シルク層から生成。エディタ専用の十字マークや補助線は印刷図に含まれない。裏面図はガーバーの上面基準のため文字が鏡像になる。

| 基板 | 表面 | 裏面 |
|---|---|---|
| UNO REV B | [シルクSVG](previews/uno-rev-b-top-silk.svg) | [シルクSVG](previews/uno-rev-b-bottom-silk.svg) |
| Audio REV D | [シルクSVG](previews/audio-rev-d-top-silk.svg) | [シルクSVG](previews/audio-rev-d-bottom-silk.svg) |

## 今後の更新ルール

1. 製造用データを改訂する際は、変更した基板だけ次の英字REVへ進める（UNO: B→C、Audio: D→E）。作業途中の保存ごとには進めない。
2. 表裏シルク、ここにある履歴、部品変更があればBOMと仕様書も同時更新する。
3. リリース前にDRC、回路図・PCBネットリスト、ガーバー／ドリル、コネクタの上面・嵌合面を確認する。DRC合格だけで製造承認にしない。
4. 製造リリース時のGitコミットを記録し、製造データ名に基板名とREVを入れる。今回のシルク確認ZIPは作業キャッシュ内にあり、注文用リリースではない。

未解決の製造・購入確認事項は修正記録を参照。このページの更新だけでは実機動作確認・製造リリース・GitHubへのプッシュを意味しない。
