airpocket-soundman/IchiPing-UNO-Q/board/REVISIONS.html

部品表 ／ Markdown版

# 基板リビジョン・シルク確認

更新: 2026-09-08。正本は board/Ichiping uno q.eprj2（EasyEDA）。元のIchiPingは変更していません。

基板 | PCB文書 | 旧表記 | 現在
UNO Q Shield | uno_q_shield 484a25750631f0fe | REV A / 2026-08-24 | REV B / 2026-09-08
Audio Shield | analog_shield 86c9249a00f4733c | REV C / 2026-08-25 | REV D / 2026-09-08

表面にREV、裏面にREVと日付を印刷。旧版表記は置換済みです。

設計検査済み・製造未リリース。仕様書の「Rev B 設計入力」は過去の外形拡張案の文書番号で、このUNO基板REV Bとは別です。外形拡張案は適用していません。

## 今回の変更

- 26種類のフットプリントでカスタム層の部品枠・極性マークを表面シルク層へ移動。組立層・配置確認用の枠は保持し、印刷枠は部品に追従します。
- 文字は原則50 mil（1.27 mm）、密集部45 mil（1.143 mm）。従来30〜31.5 milだった説明・容量表示を拡大。新版番号60 mil（1.524 mm）。
- 文字線幅7 mil（0.178 mm）、表面新版番号8 mil（0.203 mm）、枠線6 mil（0.152 mm）以上。部品番号・容量表示の配置も調整。
- Audio J14/J15に1番ピン目印。ジャンパには単なるOPEN/CLOSEDでなく次表の機能を表示。
- 今回のシルク修正では部品位置・配線・ビア・パッド・ネット・ベタを変更していません。
- 同日のJ14/J15列方向修正、0Ω抵抗のジャンパ化、配線修正もこの版に含みます。詳細は 修正記録。

## ジャンパの機能表示

REV D内の未リリース調整。45 mil文字をジャンパ脇・下側へ配置し、部品位置・配線を変えずに収めました。

ジャンパ | 開放時のシルク | 短絡時のシルク
JP_GAIN | OPEN=9dB | SHORT=12dB
JP_MUTE | OPEN=ON | SHORT=MUTE
JP_LR | OPEN=UNDEF | SHORT=L

GAINはMAX98357AのI²Sモードで、モジュール側に追加のGAIN設定抵抗がない場合。JP_LRにはシールド側のプルアップ／プルダウンがなく、モジュール側の設定がなければ開放時は入力が浮きます。UNDEFは左右未確定でありRではありません。通常は短絡してLを選択。開放／短絡で左右を確実に切り替えるには別途回路変更が必要です。

根拠: MAX98357A Table 8 / Shutdown (https://www.analog.com/media/en/technical-documentation/data-sheets/MAX98357A-MAX98357B.pdf)、INMP441 L/R (https://invensense.tdk.com/wp-content/uploads/2015/02/INMP441.pdf)。

## 確認結果

両PCBの厳密DRCは0件。保存済みPCBネットリストは変更前と一致（UNO 19部品70ピン、Audio 12部品107ピン）。変更前に回路図との一致も確認済み。配線・ビア・パッド・部品位置・ネット割当・ベタ定義の比較も一致しています。

以下は画面の補助線ではなく、EasyEDAが出力した実際のガーバーのシルク層です。エディタ専用十字マークは含まれません。裏面はガーバーの上面基準表示なので文字が鏡像になります。

## UNO Q Shield — REV B

UNO REV B 表面シルク

表面: 部品枠・部品番号・容量・REV B

UNO REV B 裏面シルク

裏面: REV B / 2026-09-08

## Audio Shield — REV D

Audio REV D 表面シルク

表面: 部品枠・部品番号・容量・端子説明・REV D

Audio REV D 裏面シルク

裏面: REV D / 2026-09-08

## 更新ルール

1. 製造用データを改訂する際、変更した基板のみ次の英字REVへ進めます（UNO B→C、Audio D→E）。途中保存ごとには進めません。
2. 表裏シルク・本履歴を揃え、部品変更時はBOM・仕様書も更新。
3. リリース前にDRC、回路図・PCBネットリスト、ガーバー／ドリル、コネクタの上面・嵌合面を確認。DRC合格だけで製造承認にしません。
4. リリース時のGitコミットを記録し、製造データ名に基板名とREVを付与。今回の確認ZIPは作業キャッシュ内の検査用で、注文用リリースではありません。

未解決の製造・購入確認は修正記録を参照。本ページの更新は実機動作確認・製造リリース・GitHubへのプッシュを意味しません。
