airpocket-soundman/IchiPing-UNO-Q/output/pdf/audio-schematic-before.pdf

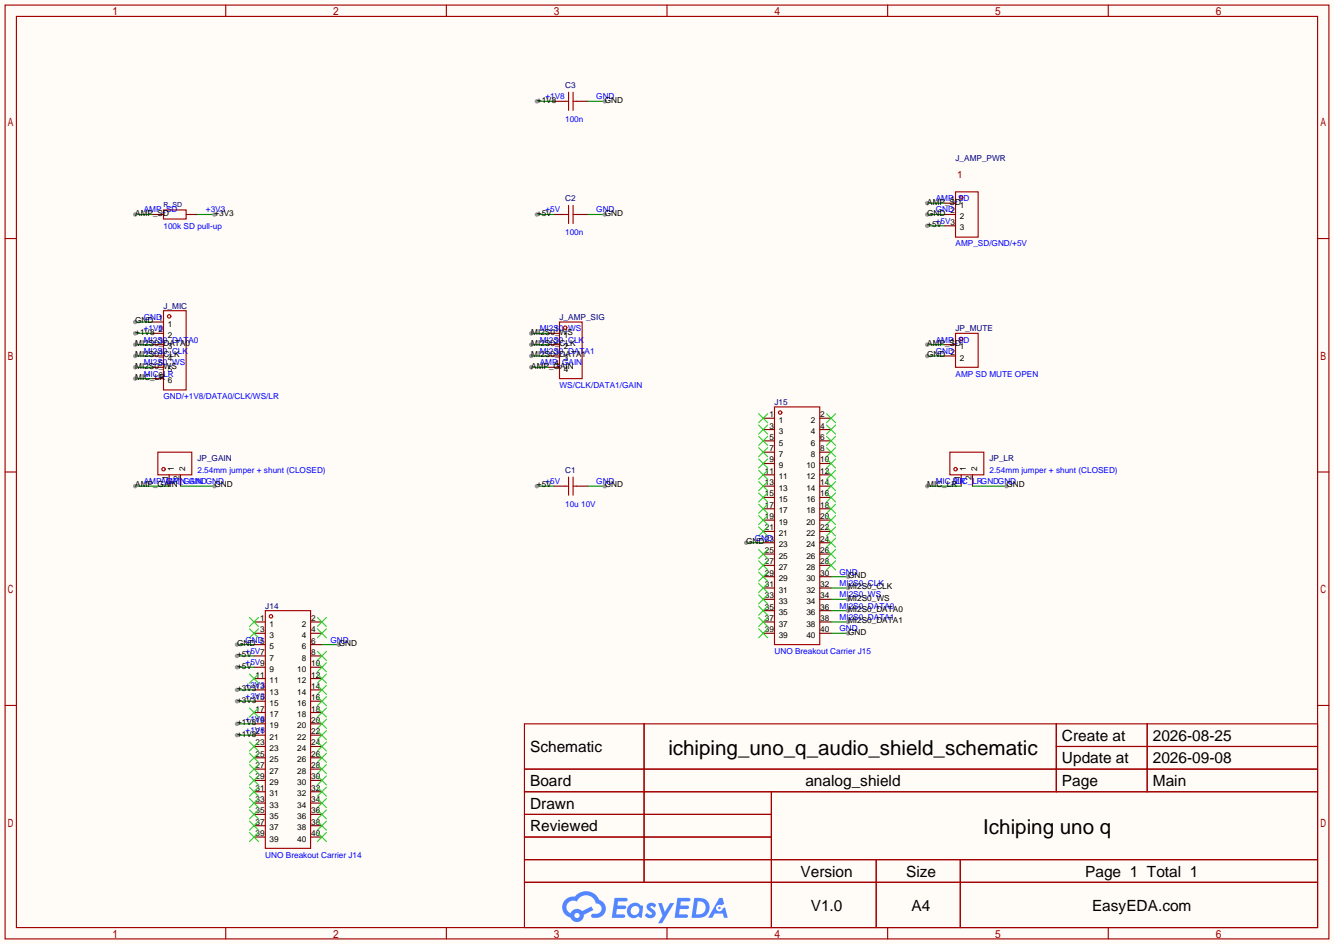
[picture p42: page 1]

Schematic | ichiping_uno_q_audio_shield_schematic | Create at | 2026-08-25

Update at | 2026-09-08

Board | analog_shield | Page | Main
Drawn | | Ichiping uno q
Reviewed

Version | Size | Page 1 Total 1
V1.0 | A4 | EasyEDA.com
