airpocket-soundman/IchiPing-UNO-Q/output/pdf/uno-schematic-before.pdf

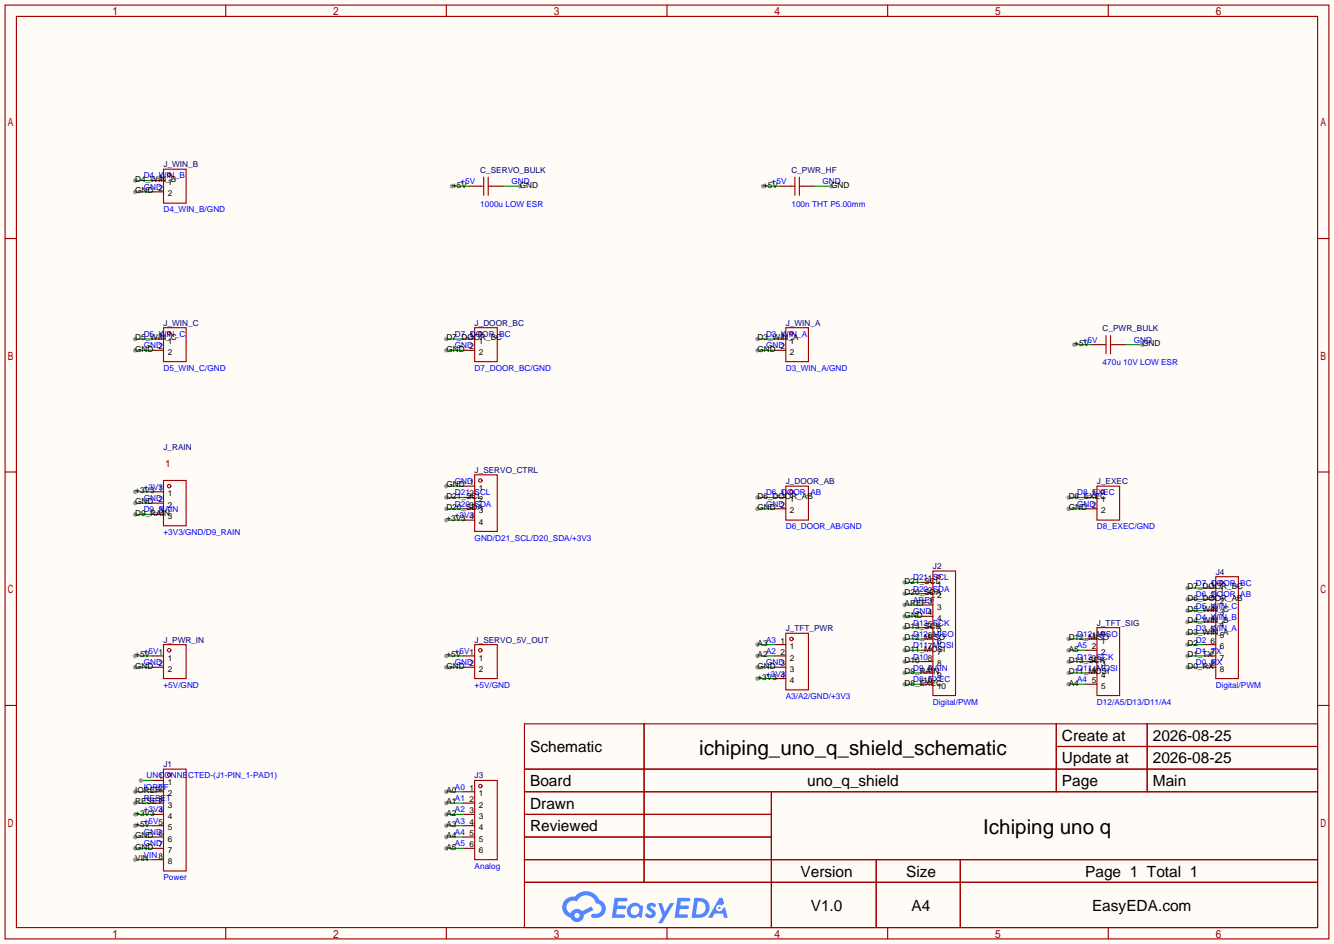
[picture p43: page 1]

Schematic | ichiping_uno_q_shield_schematic | Create at | 2026-08-25

Update at | 2026-08-25

Board | uno_q_shield | Page | Main
Drawn | | Ichiping uno q
Reviewed

Version | Size | Page 1 Total 1
V1.0 | A4 | EasyEDA.com
