airpocket-soundman/IchiPing-UNO-Q/(commit log)

2026-08-21 feat: start independent IchiPing UNO Q port
    [aggregated_L.csv, aggregated_M.csv, aggregated_S.csv, aggregated_XL.csv, bom.csv, confusion_14cls.csv, confusion_32cls.csv, fft.csv]
2026-08-21 docs: record UNO Q audio probe result
2026-08-21 docs: add UNO Q GPIO wiring diagram
2026-08-21 docs: add display and MI2S audio wiring
2026-08-21 feat: switch UNO Q display to external ILI9341
2026-08-24 docs: move Hackster BOM to Things section
2026-08-24 Add UNO Q shield board designs
    [ichiping_uno_q_audio_shield.dsn, ichiping_uno_q_audio_shield.kicad_pcb, ichiping_uno_q_audio_shield.sch, ichiping_uno_q_shield.dsn, ichiping_uno_q_shield.kicad_pcb, ichiping_uno_q_shield.sch]
2026-08-24 Add 470uF filtering to 5V input
    [ichiping_uno_q_shield.dsn, ichiping_uno_q_shield.kicad_pcb]
2026-08-24 Revise audio shield layout and schematic
    [ichiping_uno_q_audio_shield.dsn, ichiping_uno_q_audio_shield.kicad_pcb, ichiping_uno_q_audio_shield.kicad_sch, ichiping_uno_q_audio_shield.sch]
2026-08-24 Add UNO shield schematic and EasyEDA DRC setup
    [ichiping_uno_q_shield.kicad_sch, ichiping_uno_q_shield.sch]
2026-08-24 Add THT SMD and hybrid shield variants
    [ichiping_uno_q_audio_shield_hybrid.kicad_pcb, ichiping_uno_q_audio_shield_hybrid.kicad_sch, ichiping_uno_q_audio_shield_hybrid.sch, ichiping_uno_q_audio_shield_smd_full.kicad_pcb, ichiping_uno_q_audio_shield_smd_full.kicad_sch, ichiping_uno_q_audio_shield_smd_full.sch, ichiping_uno_q_audio_shield_tht.kicad_pcb, ichiping_uno_q_audio_shield_tht.kicad_sch]
2026-08-25 Refactor shield designs as EasyEDA-native boards
    Keep one canonical mixed-assembly design per shield, remove KiCad-derived variants, add board-specific BOMs, and repair schematic/PCB Device, Footprint, Unique ID, and net associations. Convert UNO mounting holes to standalone NPTH primitives and document zero-difference netlist/DRC requirements.
    [bom.csv, ichiping_uno_q_audio_shield.dsn, ichiping_uno_q_audio_shield.kicad_pcb, ichiping_uno_q_audio_shield.kicad_sch, ichiping_uno_q_audio_shield.sch, ichiping_uno_q_audio_shield_hybrid.kicad_pcb, ichiping_uno_q_audio_shield_hybrid.kicad_sch, ichiping_uno_q_audio_shield_hybrid.sch]
2026-08-25 Fix EasyEDA schematic-PCB netlist linkage
2026-08-25 Enlarge UNO shield mounting holes for M3 screws
2026-08-25 docs: add Akizuki procurement BOM and HTML board spec
    [bom.csv]
2026-08-25 docs: align BOM with all-through-hole EasyEDA design
    [bom.csv]
2026-09-07 docs: document shield pin mappings and audit findings
    [bom.csv]
2026-09-07 Add live switch-state verification
2026-09-08 Log live switch state changes
2026-09-08 Update UNO Q shield designs, schematic reviews and bring-up results
    [bom.csv]
2026-09-08 Add UNO Q servo bring-up controls
2026-09-12 UNO Q: PRBS runtime, 24-bit capture, automated collection and training tools
    - Audio: sudo-free safe-audio-test (audio + gpiod groups), PRBS16k excitation
    with cached PCM and batch mode, S32_LE capture, ambient (silence) capture,
    operator chime, user-mode runtime worker.
    - App: PRBS capture alignment and x16 original-collector scale, evaluation
    mailbox (arm / set_state / follow_switches / calibrate_baseline), flicker-free
    ILI9341 rendering with procedural sprites; deployed model = s1-8 + freq-warp.
    - Training: --freq-warp temperature augmentation, --init-ckpt fine-tuning.
    - PC tools: collector (Gray-code, fixed settle), dataset export, evaluation,
    model comparison table.
    Co-Author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
    [analyze-white-noise-calibration.py, audio-smoke-test.py, audio_runtime.py, baseline_store.py, ichiping_cli.py]
2026-09-12 docs: English documentation site, results and Hackster contest article
    - README (English) is the GitHub Pages landing page; HTML is generated from the
    Markdown sources by tools/build_site.py (no third-party dependency).
    - docs/uno_q: hardware, software, signal and model, data and training, results,
    reproduce.
    - docs/hackster: contest story (English) and Japanese review copy.
    - pc/runs: model comparison table and aggregate evaluation results.
2026-09-12 docs: add the UNO Q wiring diagram (SVG for the site, PNG for Hackster)
    The diagram replaces the outdated pin tables of the old draft (TFT on
    A2-A5, D9 unused, audio verified incl. GPIO28 SD_MODE with 10 kOhm to GND).
    It is generated by tools/make_wiring_diagram.py.
    [make_wiring_diagram.py]
2026-09-12 UNO Q: autostart inference mode after power-on
    - App is the App Lab default app; the audio worker starts from a user
    crontab @reboot via start-runtime-worker.sh (removes a stale
    worker-ready.json first).
    - Boot sequence: close all servos (new MCU close_all_servos), record a
    fresh all-closed baseline, then follow the switches.
    - safe-audio-test.sh verifies the board by SoC serial when no USB host
    created the gadget (standalone power supply).
    [main.py, sketch.ino]
2026-09-13 Remove FRDM-era documents, firmware and datasets; keep only UNO Q material
    Kept: uno_q/, docs/uno_q, docs/hackster, docs/img, UNO Q shield design
    (board/, hardware/easyeda, hardware/bom.*, docs/pins.xlsx, output/pdf),
    pc/uno_q_*.py, pc/training, export_neutron_4d.py, the model comparison
    and the full_32_eval_v1 fixture used by test_packaged_model.py.
    The original project keeps the FRDM history.
    [aggregated_L.csv, aggregated_M.csv, aggregated_S.csv, aggregated_XL.csv, confusion_14cls.csv, confusion_32cls.csv, fft.csv, labels.csv]
2026-09-13 docs: note that the UNO Q shields were AI-designed as an experiment
    The schematic drawings are not very readable, but the circuits are
    correct and the manufactured boards run the complete system.
2026-09-13 docs: drop the wiring close-up photo placeholder
2026-09-13 docs: add pipe material and 3D-printed acrylic brackets to the BOM
2026-09-13 docs: BOM lists the 3D-printed model-house parts instead of pipe and brackets
2026-09-13 Add STL files for the 3D-printed model house
    16 parts (floors, ceilings, pillars, wall panels, window, door, speaker
    and microphone holders) in hardware/3d_parts with a parts list; the BOM
    now points to them. STL is marked binary in .gitattributes.
    [ceiling1.stl, ceiling2.stl, door.stl, floor1.stl, floor2.stl, floor3.stl, mic holder.stl, pillar2.stl]
2026-09-13 Add Gerber fabrication files for the UNO Q shield and the audio shield
    Exported from EasyEDA Pro on 2026-09-13.
2026-09-13 docs: point to the Gerber files for both shields
2026-09-13 Update EasyEDA Pro project to the version the 2026-09-13 Gerbers were exported from
2026-09-13 Add model-house layout figure (house構造.png)
